Shafayat-Alam/Flapping-Foil-Propulsors-Control/subsea_mission_assurance/docs/00_Model_Report.md

# Model Report — Soft Propulsors UUV
_Generated 2026-09-03._

## Element counts

- stakeholders: 3
- expectations: 3
- moes: 1
- mops: 3
- requirements: 28
- components: 17
- interfaces: 13
- activities: 38

## V&V resourcing policy

- **Software:** Unlimited. Any form acceptable — manual or automated (host-side, sim, on-target).
- **Hardware:** Constrained to basic shop tools plus some university-lab equipment. Each hardware activity's required instrument MUST be confirmed available before it is baselined; if unavailable, substitute a documented low-cost method or mark the activity BLOCKED.
- **Confirmed tools:** digital calipers, digital scale (g), hanging/spring scale (force), tape measure / ruler, digital multimeter, food coloring / dye, thermometer / IR temp gun, overhead phone camera + mount, waterproof AprilTags + stands, stopwatch / phone timer, known calibration weights
- **Unavailable tools:** bench DC power supply, oscilloscope, clamp/inline current meter, syringe + tubing (vacuum), desiccant / humidity card

## Consistency check

**0 error(s), 0 warning(s)**

## Generated views

- `01_Stakeholder_Expectations.md`
- `02_MOE_MOP.md`
- `03_System_Requirements.md`
- `04_Architecture.md`
- `05_OPM_OPL.md`
- `06_Verification_Procedures.md`
- `07_ConOps.md`
- `08_Software_Safety.md`
- `09_Risk_Register.md`
- `10_Interface_Requirements.md`
- `11_Interface_Design.md`
- `12_ICD.md`
- `13_Integration_Plan.md`
- `14_DSM.md`
- `15_Commissioning.md`
- `16_Test_Strategy.md`
- `17_V_Model.md`
- `Commissioning_Checklist.csv`
- `DSM.csv`
- `ICD.csv`
- `INDEX.md`
- `Integration_Plan.csv`
- `Interface_Requirements.csv`
- `Interfaces.csv`
- `Requirements_Traceability_Matrix.csv`
- `Risk_Register.csv`
- `Scenario_Traceability_Matrix.csv`
- `Software_Hazard_Matrix.csv`
- `V_Model_Diagram.svg`
- `Verification_Matrix.csv`
