Shafayat-Alam/Flapping-Foil-Propulsors-Control/for_drive/MANIFEST.md

# Files staged for the external drive

This folder mirrors the destination structure on `/mnt/usb/Fin_Dynmaics/`.
At the end of the full walkthrough, copy each file below to the listed
destination (drive is currently not writable from this session — see chat).

| Local staged file | Destination on drive | Status |
|---|---|---|
| `for_drive/Fin_Dynmaics/phase1_targets.png` | `/mnt/usb/Fin_Dynmaics/phase1_targets.png` | ✅ copied |
