Shafayat-Alam/Flapping-Foil-Propulsors-Control/subsea_mission_assurance/docs/01_Stakeholder_Expectations.md

# Stakeholder Expectations
_Generated 2026-09-03 from model/. Do not edit._

### STK-PI — Principal investigator / student researcher
- **STK-EXP-01** (draft): Demonstrate autonomous homing to an AprilTag using soft flapping propulsion.

### STK-LAB — Lab / facility owner
- **STK-EXP-03** (draft): Cause no water damage to the facility; remain watertight and recoverable.

### STK-SAF — Safety observer
- **STK-EXP-02** (draft): Operate without shock, thermal, or entanglement hazard to people.
