Shafayat-Alam/Flapping-Foil-Propulsors-Control/for_drive/3D_parametric_amp-ratio_freq-ratio_phase-shift/amplitude_ratio_fx_fy.png

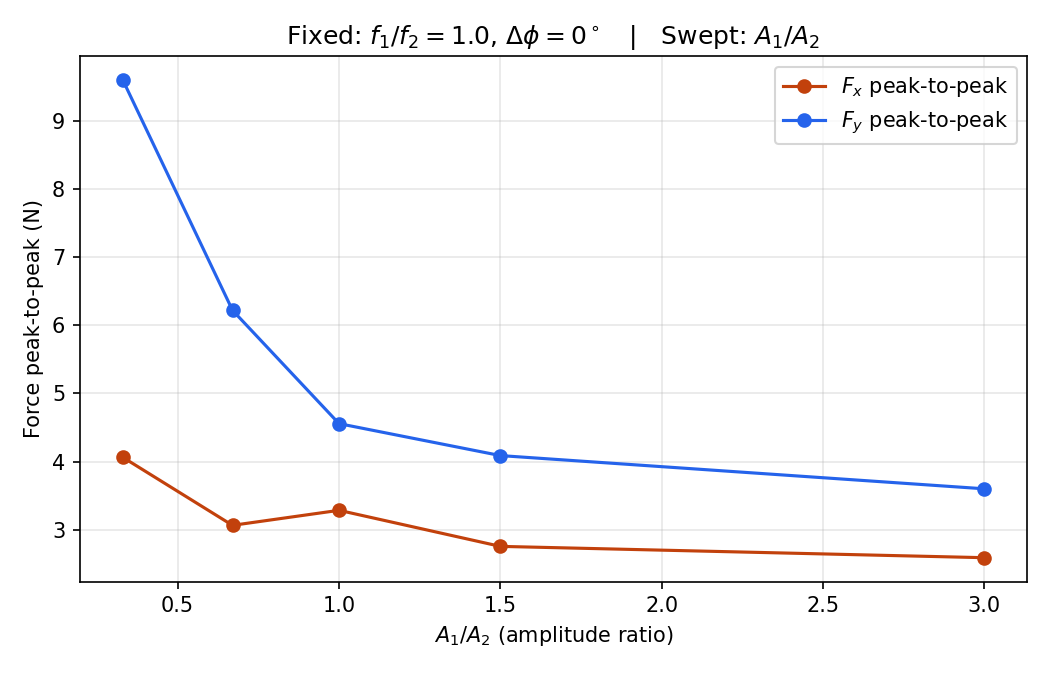
for_drive/3D_parametric_amp-ratio_freq-ratio_phase-shift/amplitude_ratio_fx_fy.png
