Shafayat-Alam/Flapping-Foil-Propulsors-Control/for_drive/3D_parametric_amp-ratio_freq-ratio_phase-shift/claim_7_peak_count_coupling.png

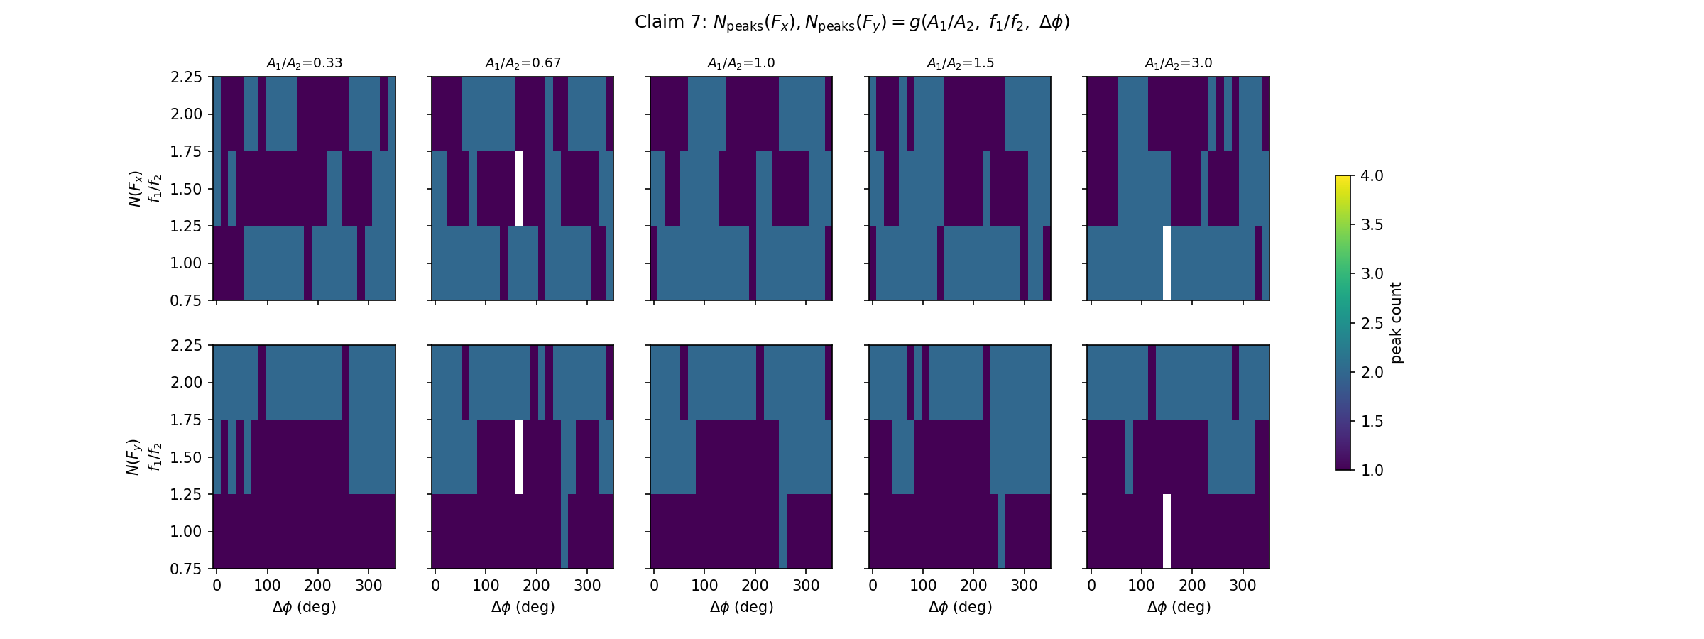
for_drive/3D_parametric_amp-ratio_freq-ratio_phase-shift/claim_7_peak_count_coupling.png
