Shafayat-Alam/Flapping-Foil-Propulsors-Control/for_drive/3D_parametric_amp-ratio_freq-ratio_phase-shift/claims_1_2_amplitude_ratio.png

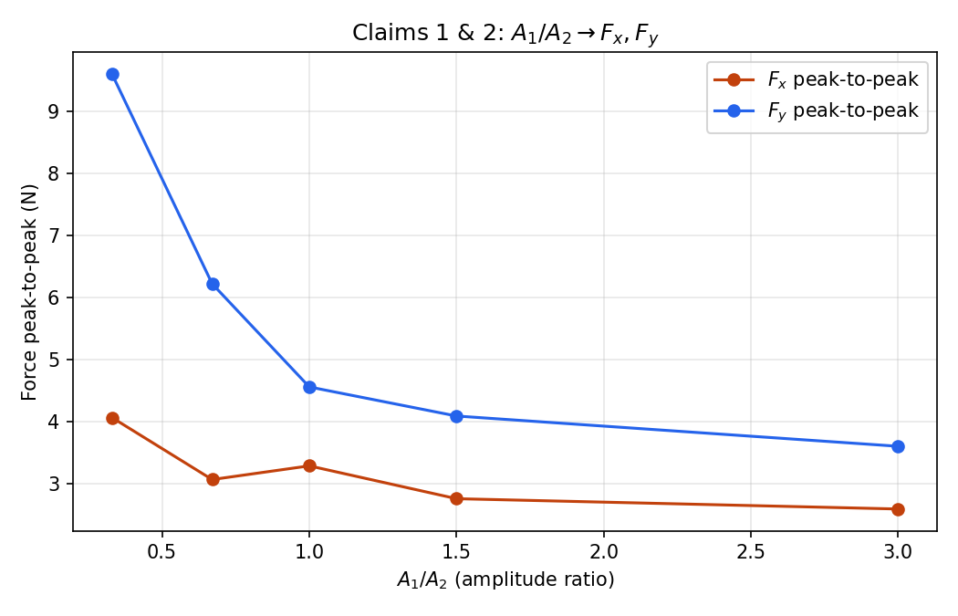
for_drive/3D_parametric_amp-ratio_freq-ratio_phase-shift/claims_1_2_amplitude_ratio.png
