Shafayat-Alam/Flapping-Foil-Propulsors-Control/for_drive/3D_parametric_amp-ratio_freq-ratio_phase-shift/claims_3_4_frequency_ratio.png

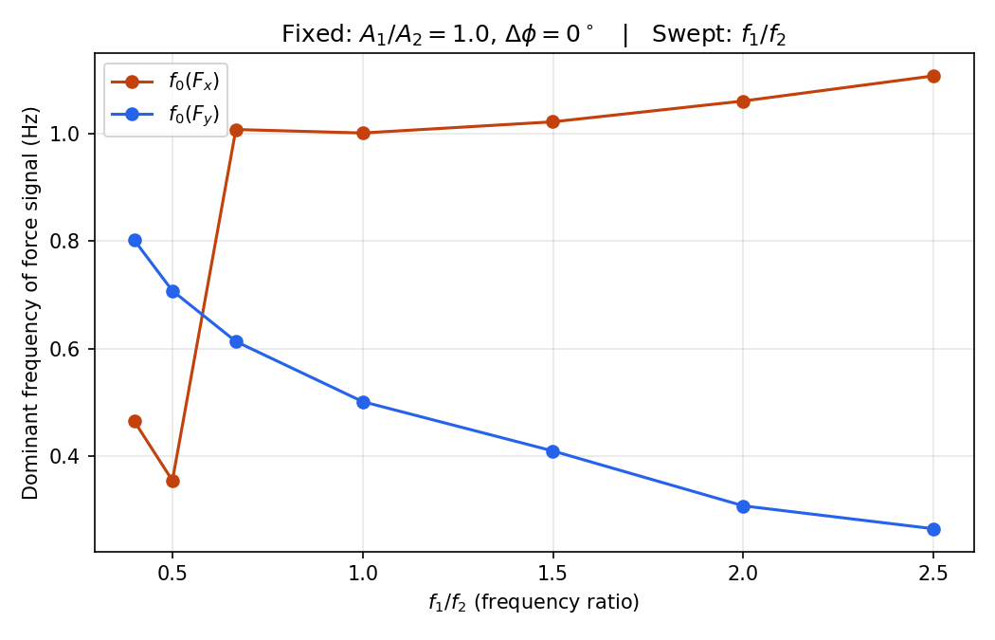
for_drive/3D_parametric_amp-ratio_freq-ratio_phase-shift/claims_3_4_frequency_ratio.png
