Shafayat-Alam/Flapping-Foil-Propulsors-Control/for_drive/3D_parametric_amp-ratio_freq-ratio_phase-shift/claims_5_6_phase_skew.png

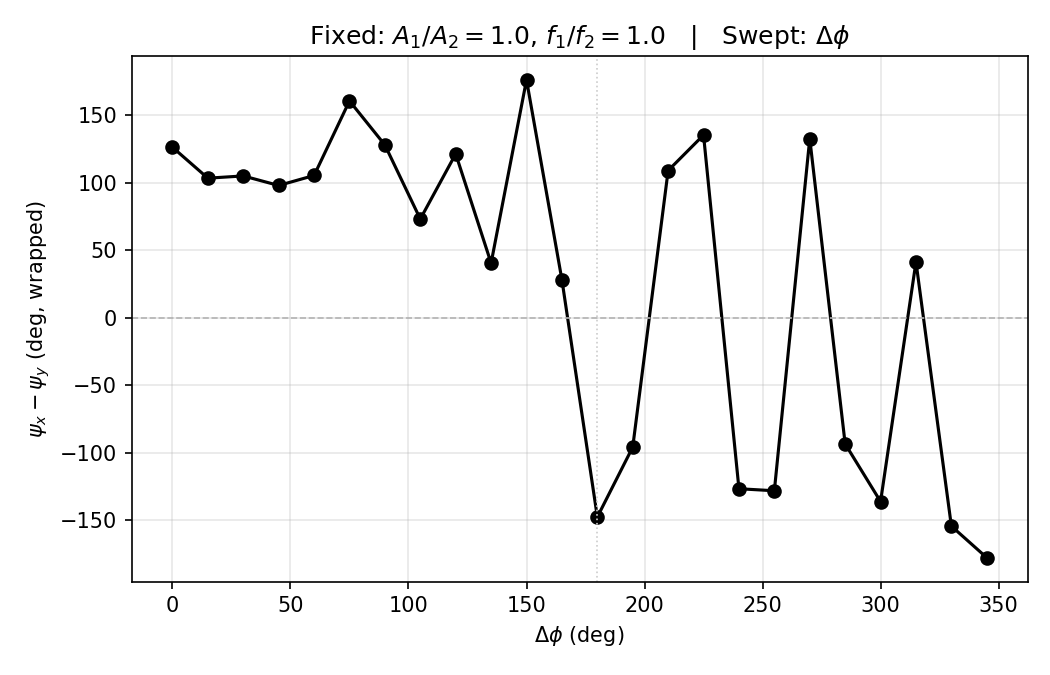
for_drive/3D_parametric_amp-ratio_freq-ratio_phase-shift/claims_5_6_phase_skew.png
