Shafayat-Alam/Flapping-Foil-Propulsors-Control/for_drive/3D_parametric_amp-ratio_freq-ratio_phase-shift/fz_p2p_coupling.png

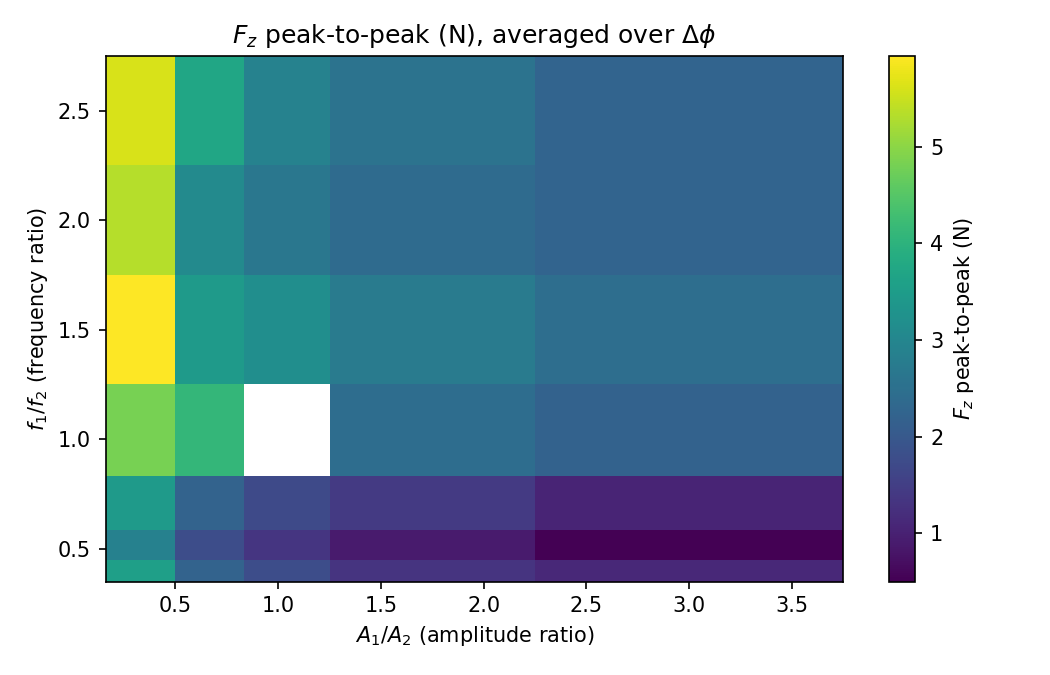
for_drive/3D_parametric_amp-ratio_freq-ratio_phase-shift/fz_p2p_coupling.png
