Shafayat-Alam/Flapping-Foil-Propulsors-Control/for_drive/3D_parametric_k_freq-ratio_phase-shift/k_sweep_force_snapshot.png

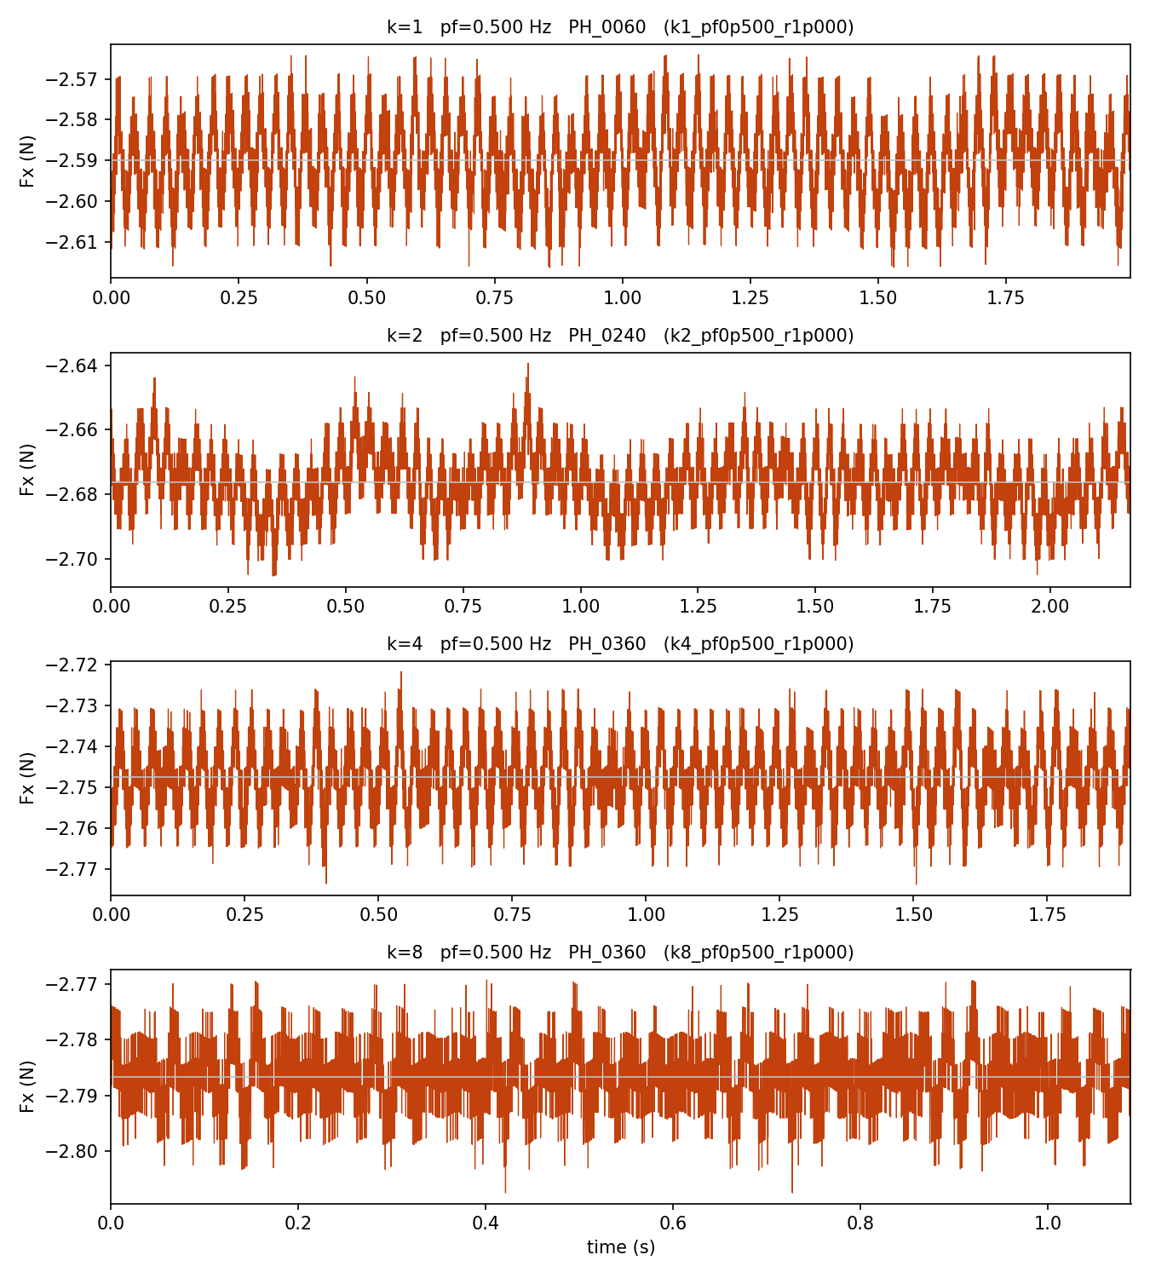
for_drive/3D_parametric_k_freq-ratio_phase-shift/k_sweep_force_snapshot.png
