Shafayat-Alam/Flapping-Foil-Propulsors-Control/for_drive/Fin_Dynmaics/phase1_targets.png

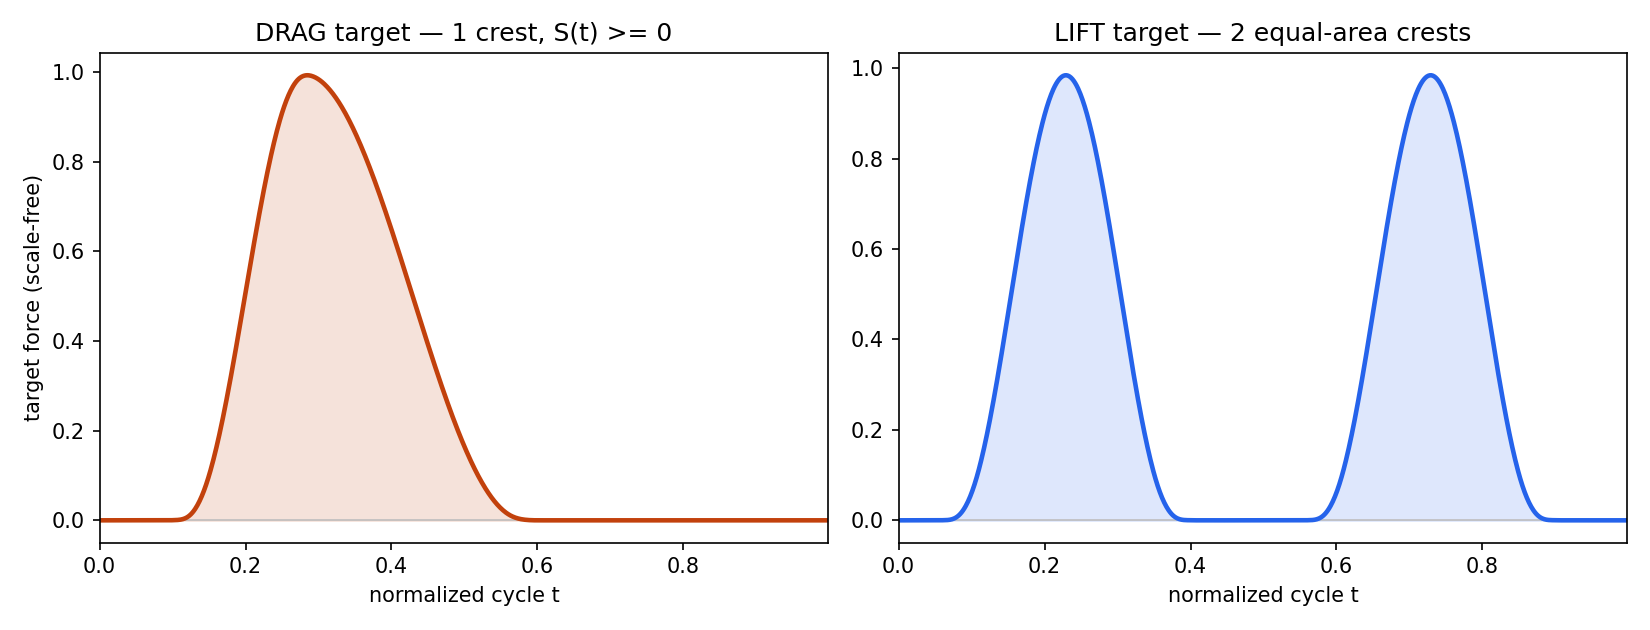
for_drive/Fin_Dynmaics/phase1_targets.png
