Shafayat-Alam/Flapping-Foil-Propulsors-Control/for_drive/profile_definition/bspline_drag.png

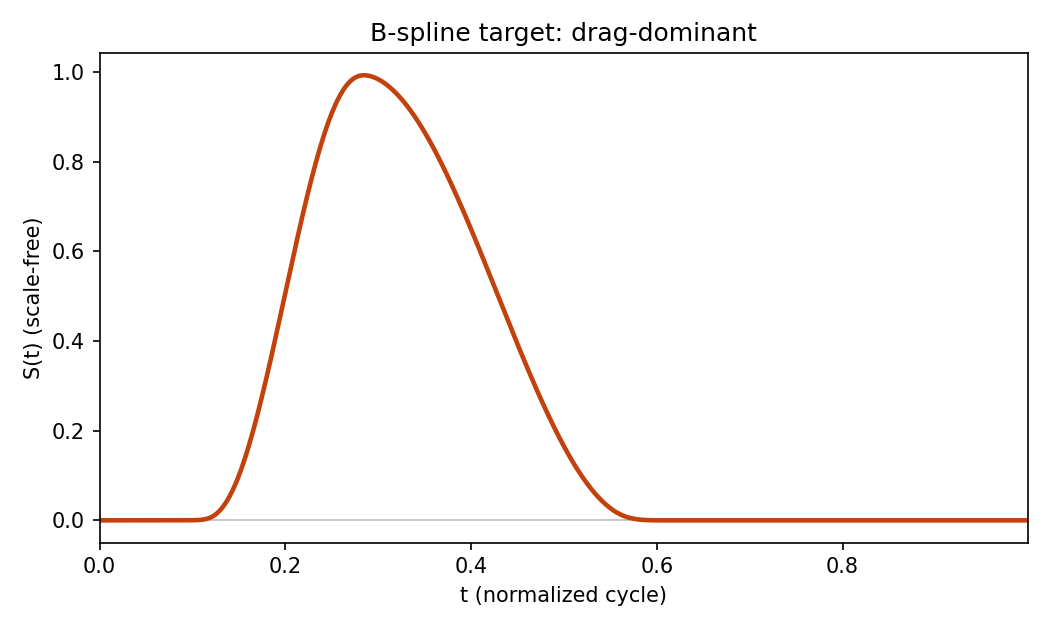
for_drive/profile_definition/bspline_drag.png
