Shafayat-Alam/Flapping-Foil-Propulsors-Control/for_drive/profile_definition/bspline_lift.png

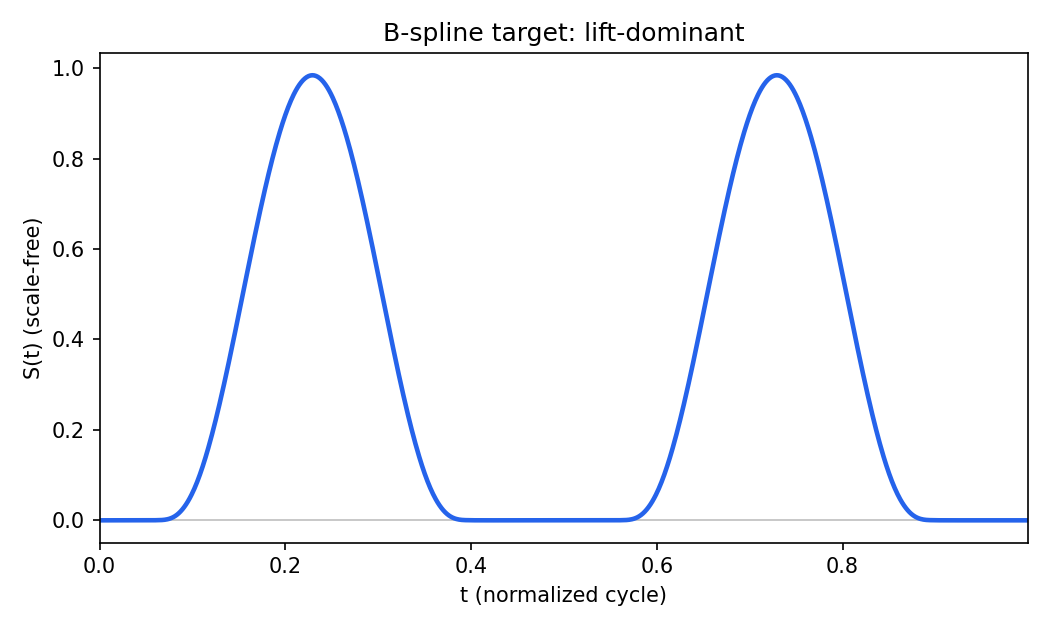
for_drive/profile_definition/bspline_lift.png
