Shafayat-Alam/Flapping-Foil-Propulsors-Control/for_drive/recent_generated_plots/CONTROL_RESPONSE_ERROR.png

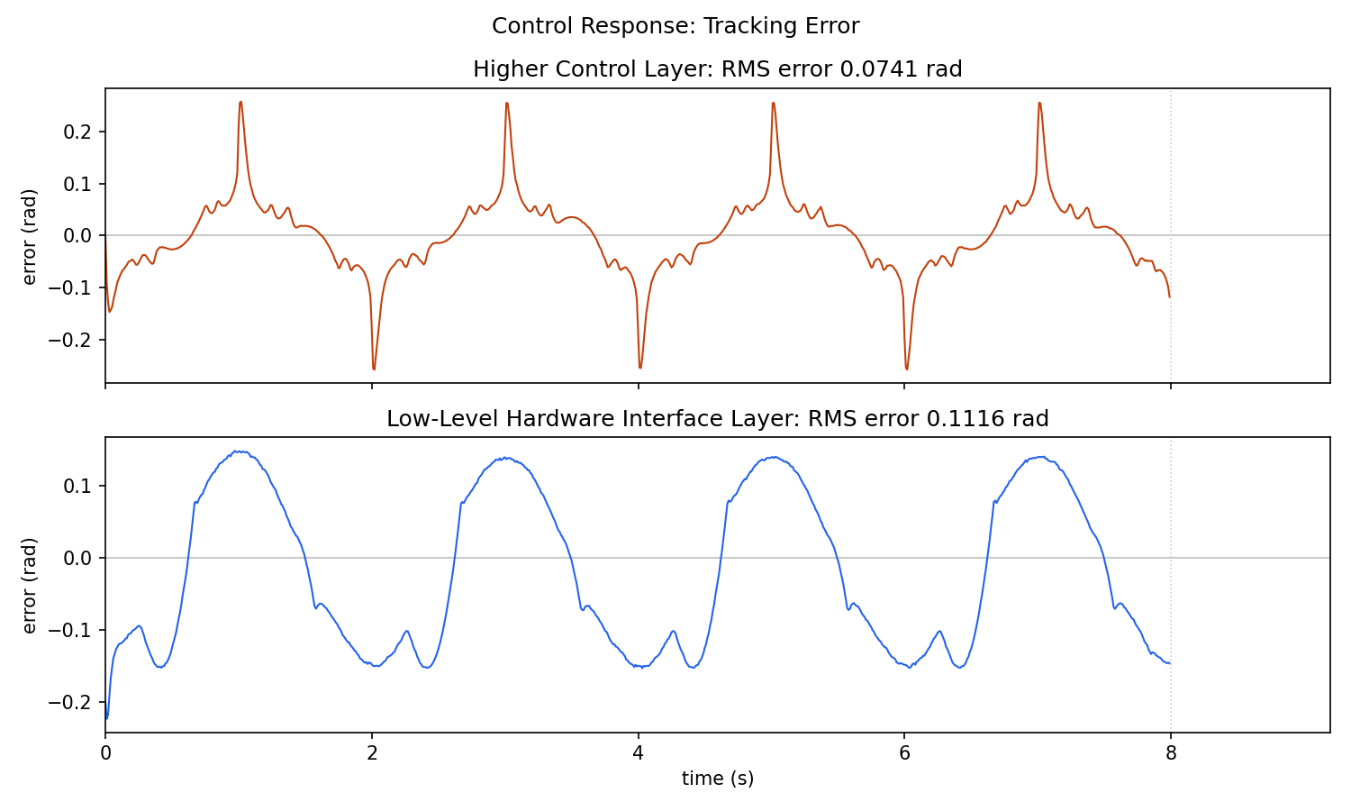
for_drive/recent_generated_plots/CONTROL_RESPONSE_ERROR.png
