Shafayat-Alam/Flapping-Foil-Propulsors-Control/for_drive/recent_generated_plots/CONTROL_RESPONSE_LOOPS.png

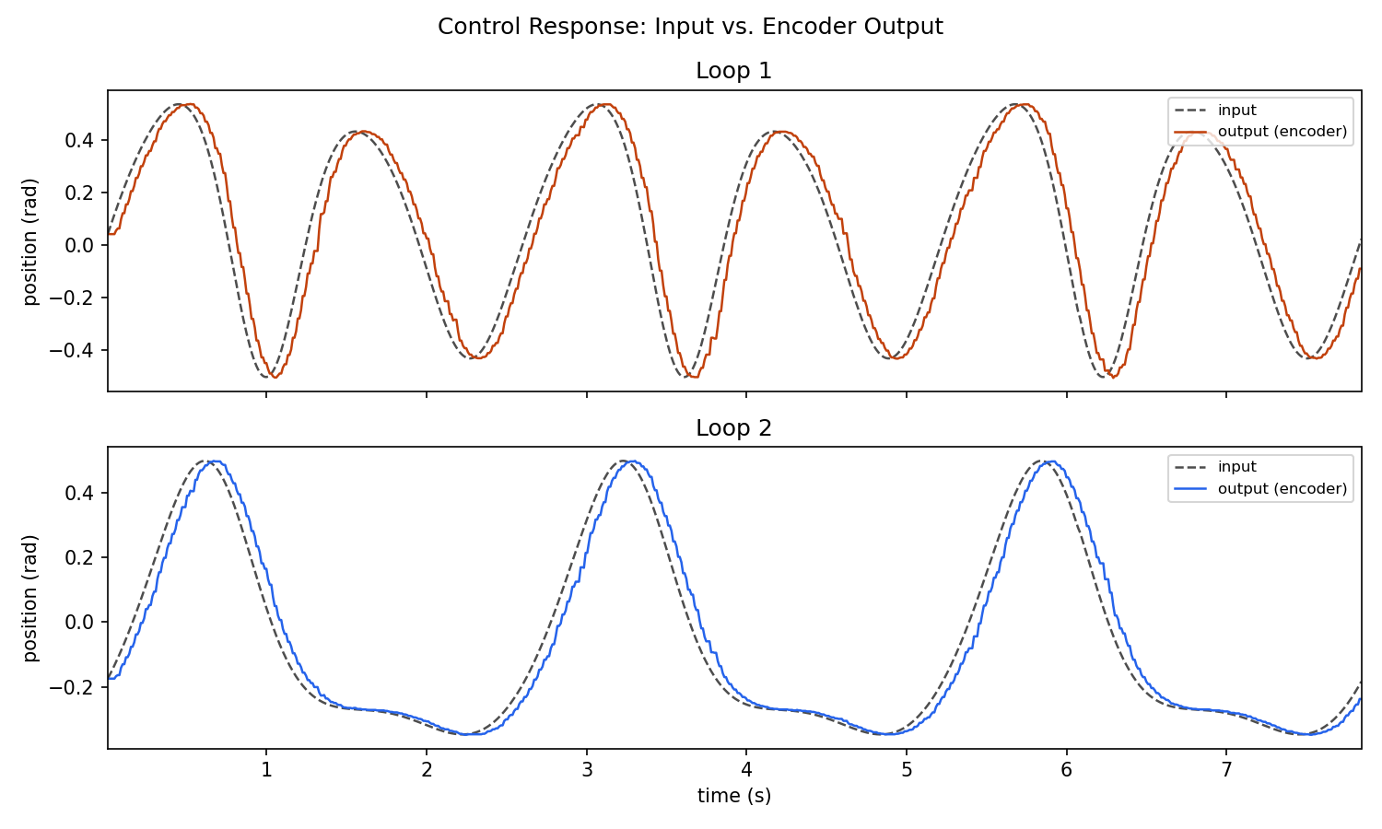
for_drive/recent_generated_plots/CONTROL_RESPONSE_LOOPS.png
