Shafayat-Alam/Flapping-Foil-Propulsors-Control/for_drive/recent_generated_plots/CRAB_FREQ_COMPARISON.png

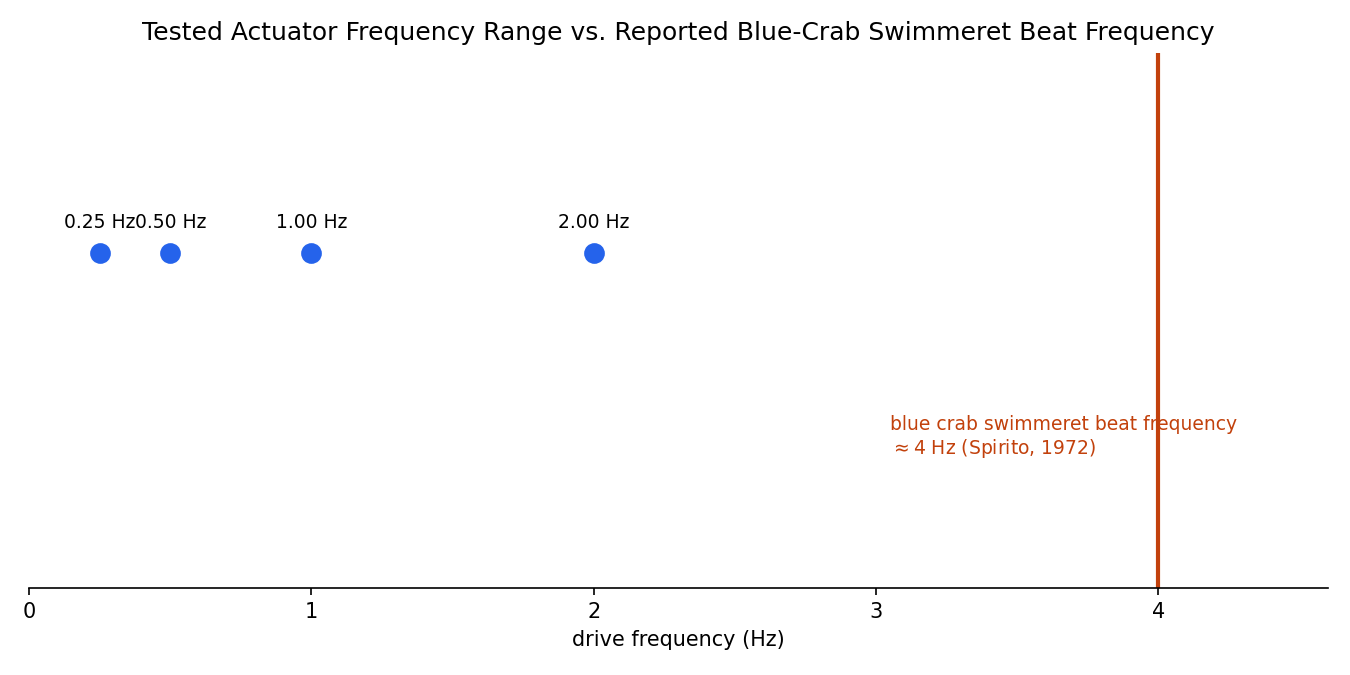
for_drive/recent_generated_plots/CRAB_FREQ_COMPARISON.png
