Shafayat-Alam/Flapping-Foil-Propulsors-Control/for_drive/recent_generated_plots/DRAG_OVERLAY.png

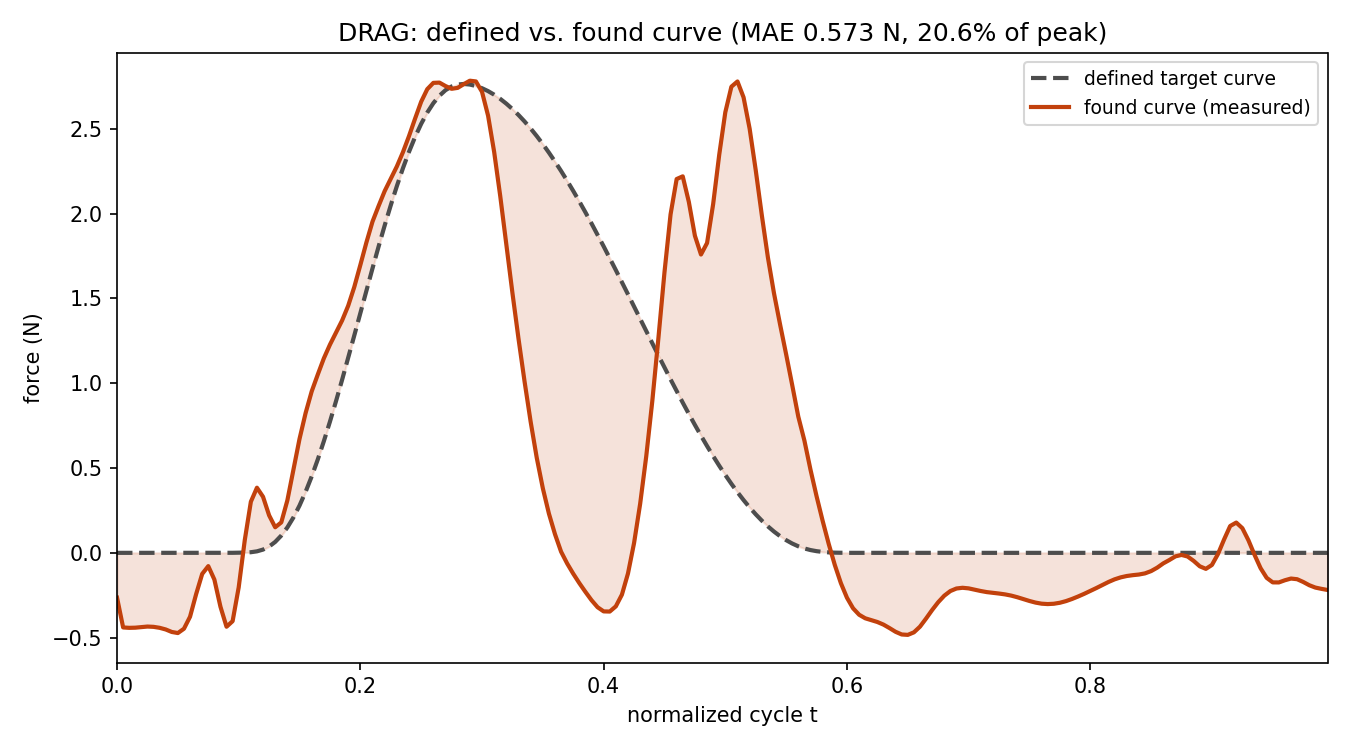
for_drive/recent_generated_plots/DRAG_OVERLAY.png
