Shafayat-Alam/Flapping-Foil-Propulsors-Control/for_drive/recent_generated_plots/FORCE_TARGET_CURVES_simplified.png

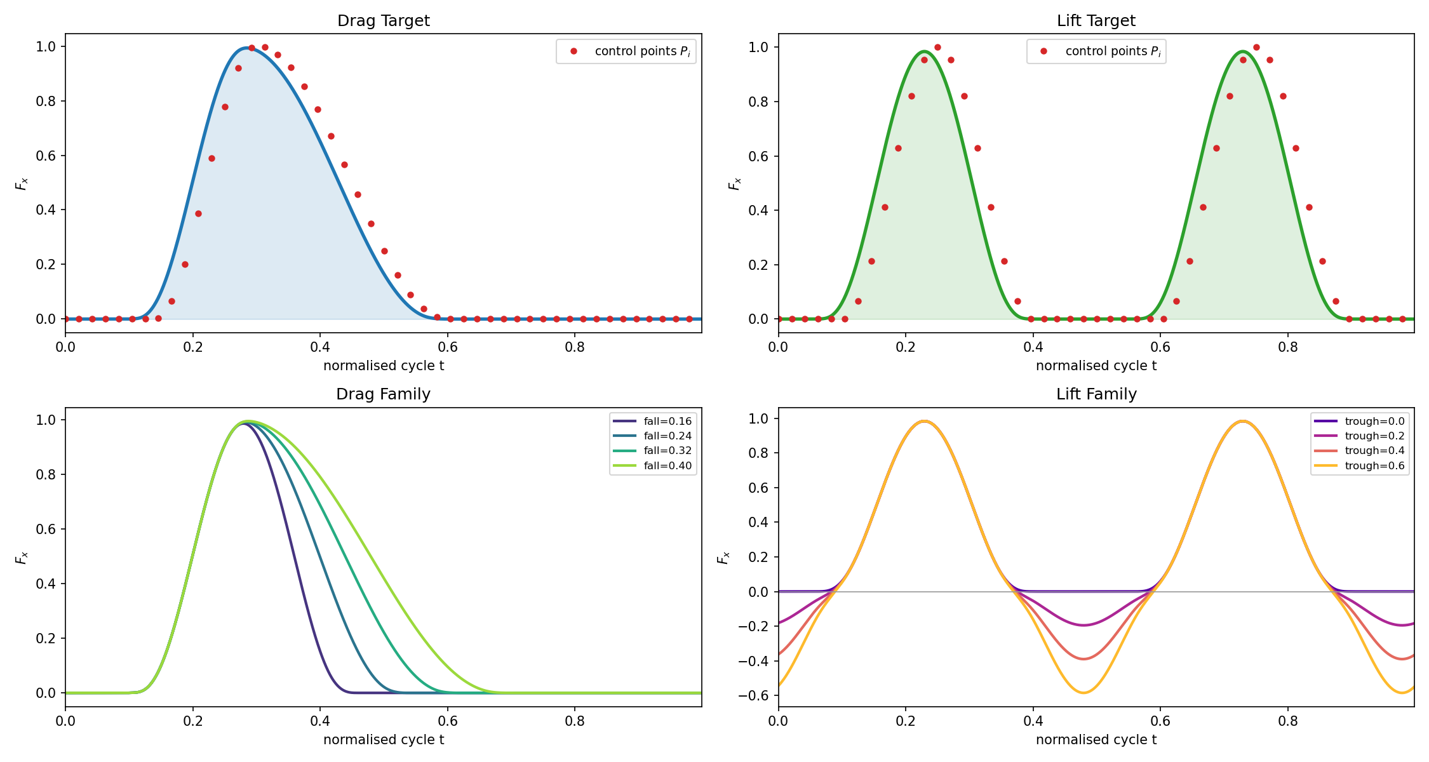
for_drive/recent_generated_plots/FORCE_TARGET_CURVES_simplified.png
