Shafayat-Alam/Flapping-Foil-Propulsors-Control/for_drive/recent_generated_plots/LIFT_OVERLAY.png

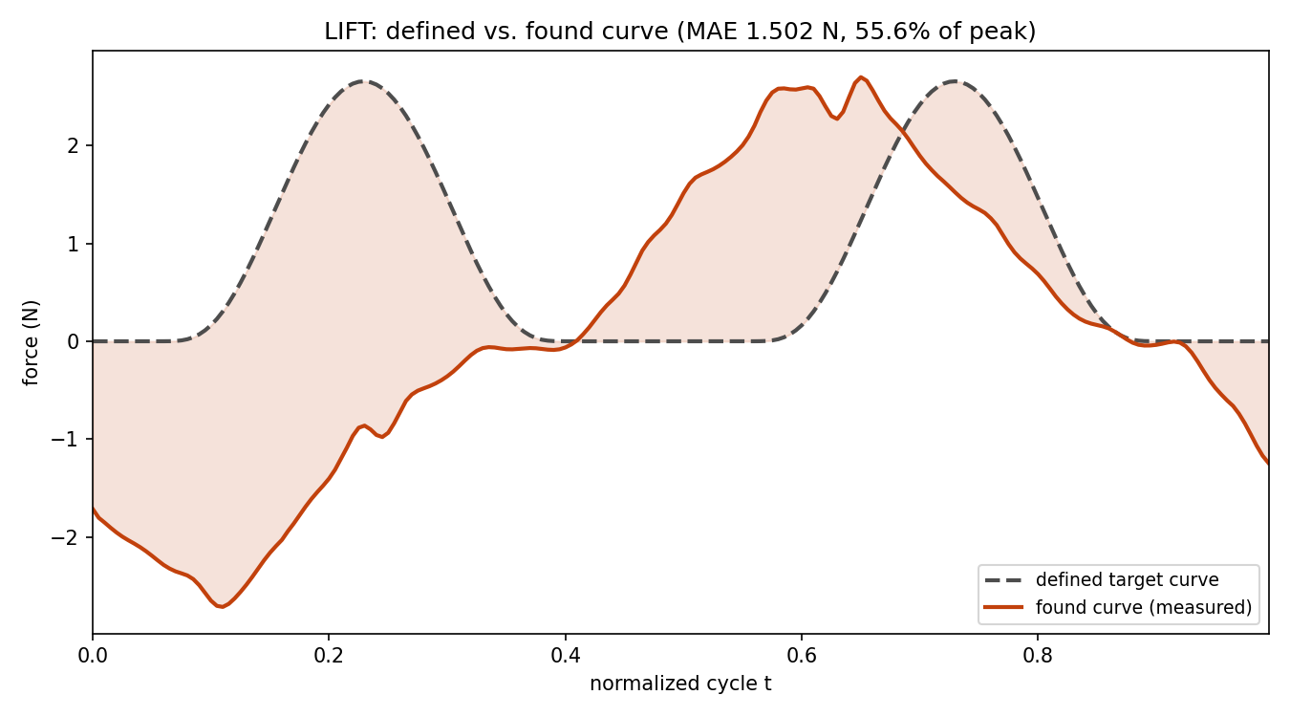
for_drive/recent_generated_plots/LIFT_OVERLAY.png
