Shafayat-Alam/Flapping-Foil-Propulsors-Control/for_drive/recent_generated_plots/LIFT_WORST_OVERLAY.png

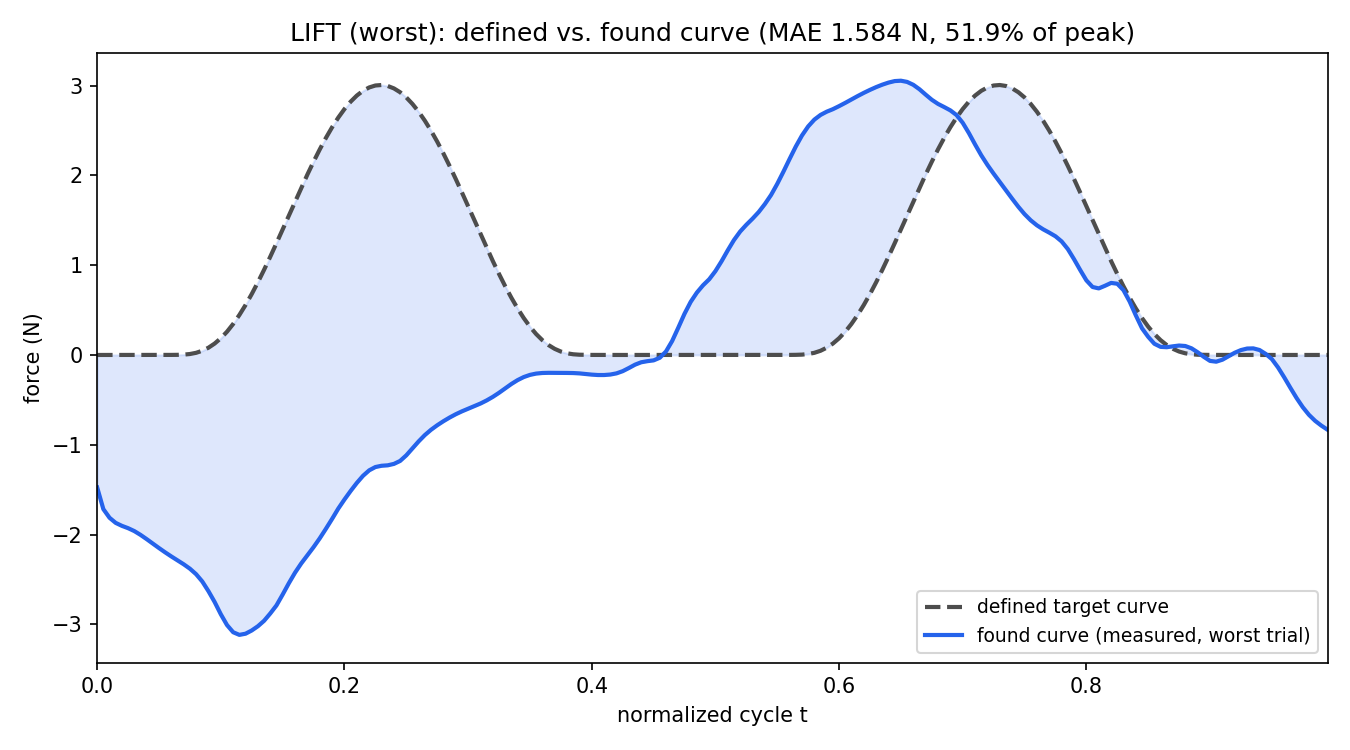
for_drive/recent_generated_plots/LIFT_WORST_OVERLAY.png
