Shafayat-Alam/Flapping-Foil-Propulsors-Control/for_drive/recent_generated_plots/pchip_drag_official.png

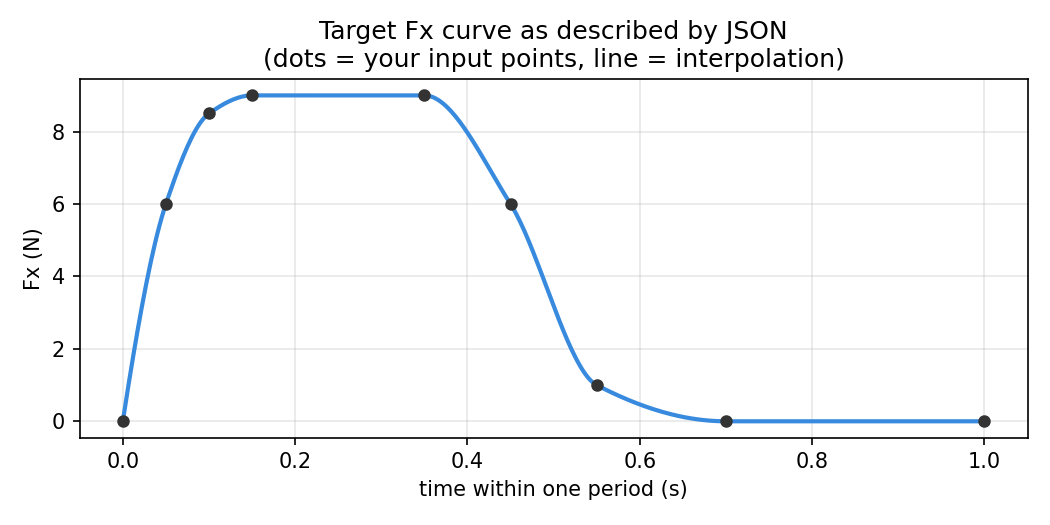
for_drive/recent_generated_plots/pchip_drag_official.png
