Shafayat-Alam/Flapping-Foil-Propulsors-Control/for_drive/recent_generated_plots/pchip_lift_official.png

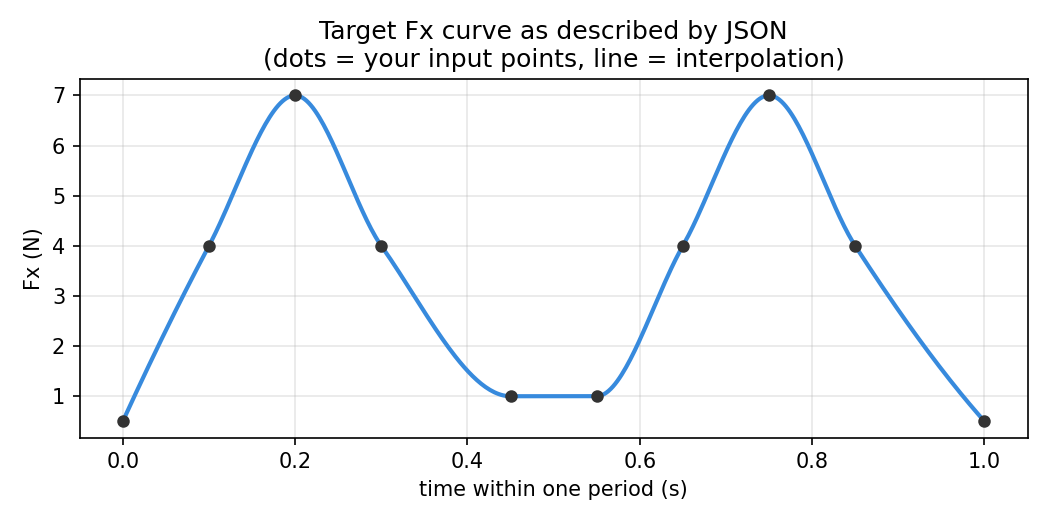
for_drive/recent_generated_plots/pchip_lift_official.png
