Shafayat-Alam/Flapping-Foil-Propulsors-Control/for_drive/recent_generated_plots/PCHIP_TARGET_CURVES.png

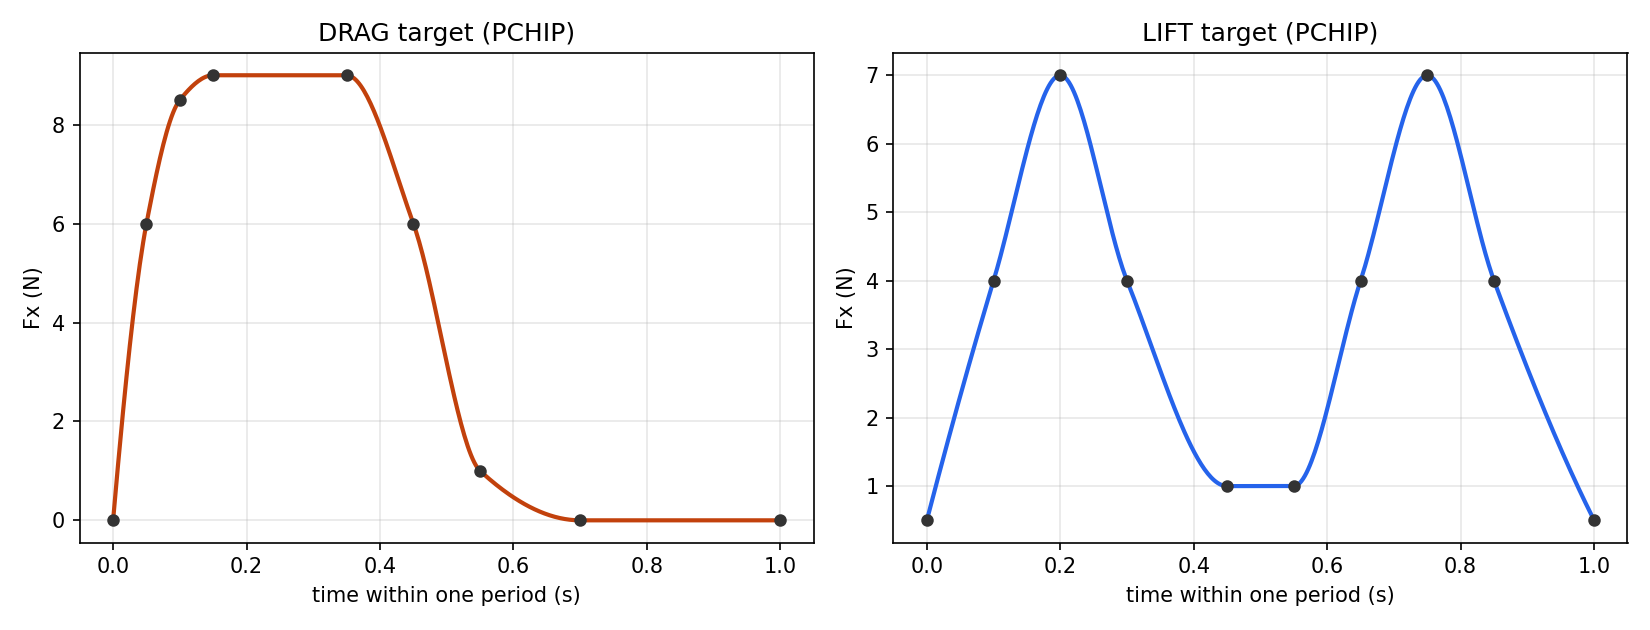
for_drive/recent_generated_plots/PCHIP_TARGET_CURVES.png
