Shafayat-Alam/Flapping-Foil-Propulsors-Control/for_drive/recent_generated_plots/RESPONSE_RATE_BOTH_LAYERS.png

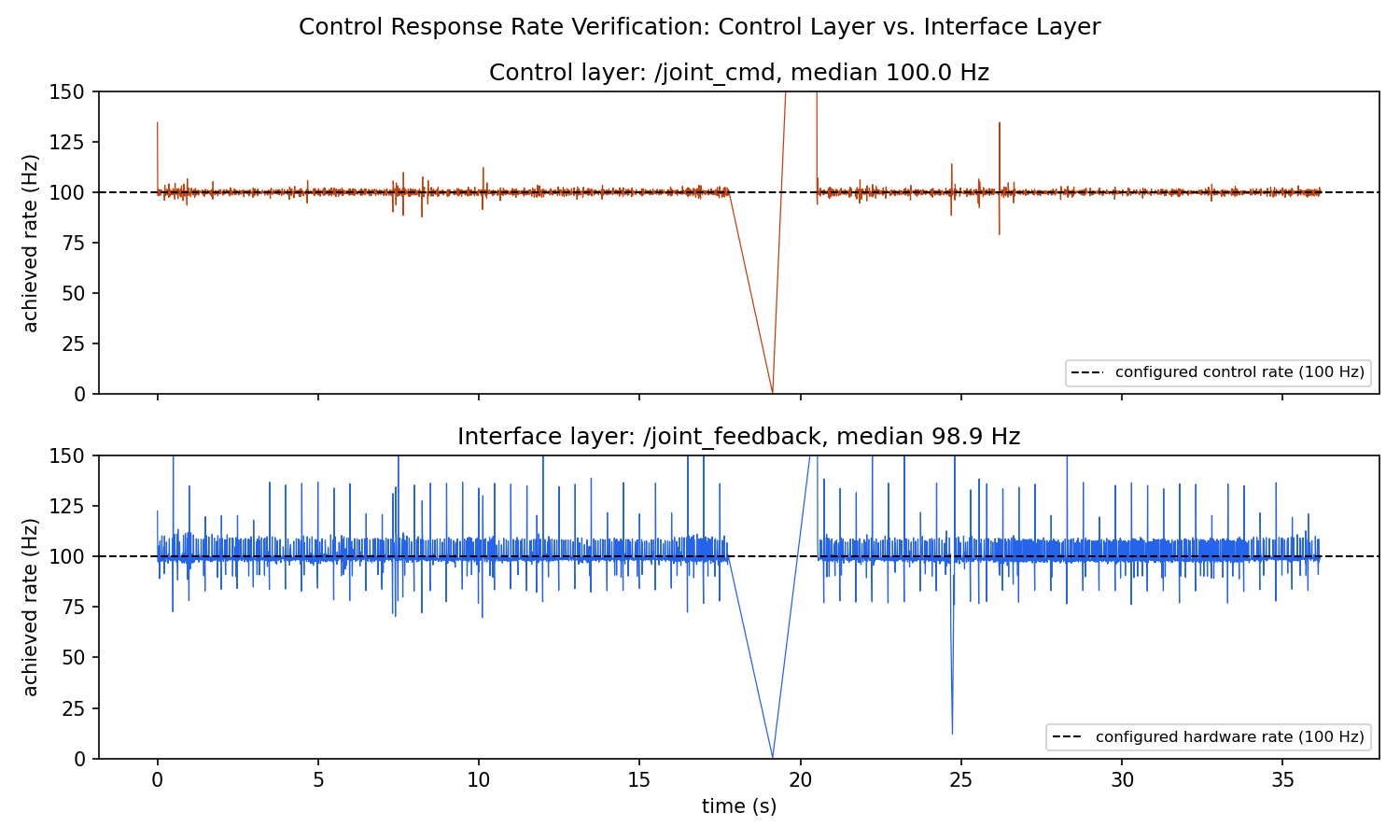
for_drive/recent_generated_plots/RESPONSE_RATE_BOTH_LAYERS.png
