Shafayat-Alam/Flapping-Foil-Propulsors-Control/for_drive/recent_generated_plots/RESPONSE_RATE_TRACKING.png

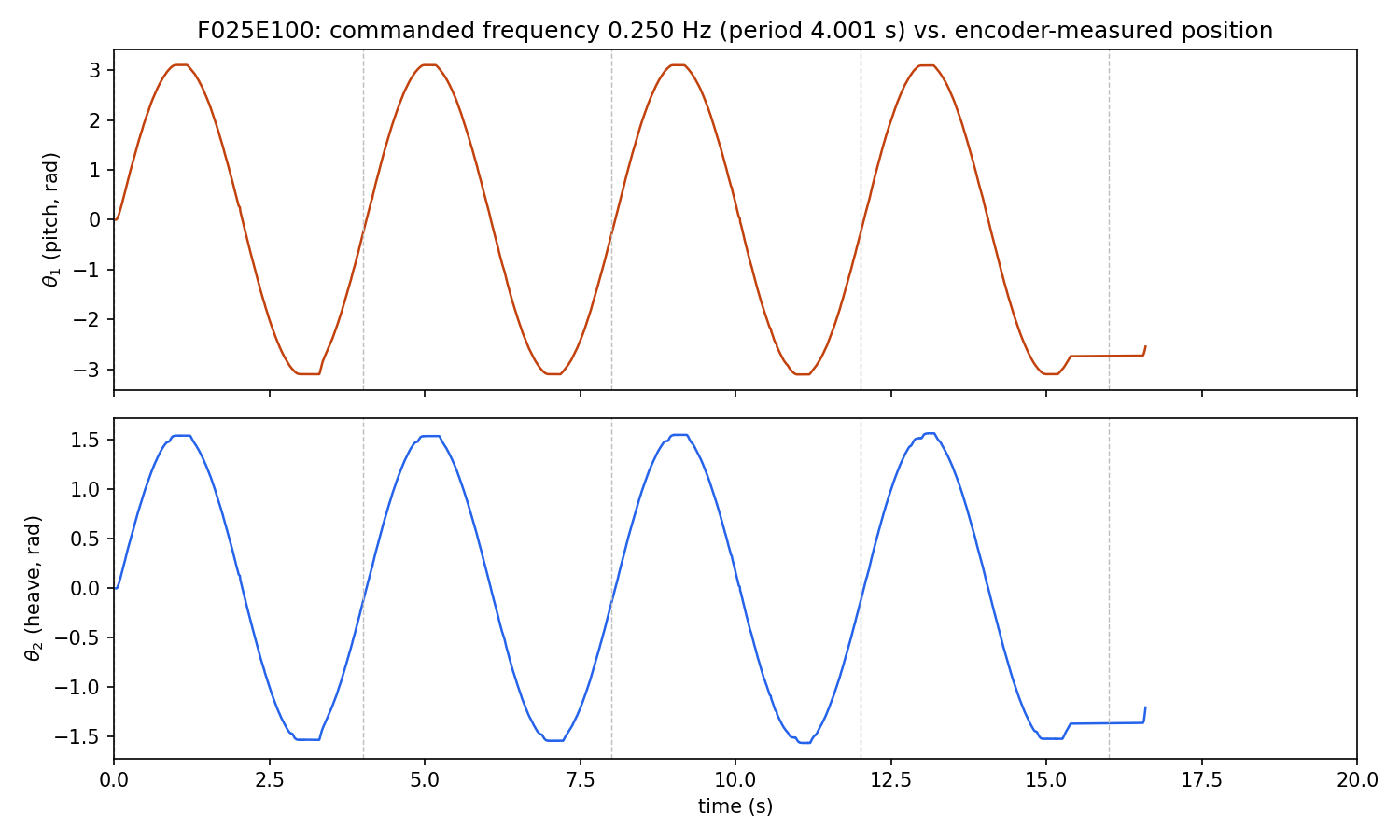
for_drive/recent_generated_plots/RESPONSE_RATE_TRACKING.png
