Shafayat-Alam/Flapping-Foil-Propulsors-Control/for_drive/recent_generated_plots/ROSGRAPH_LIVE.png

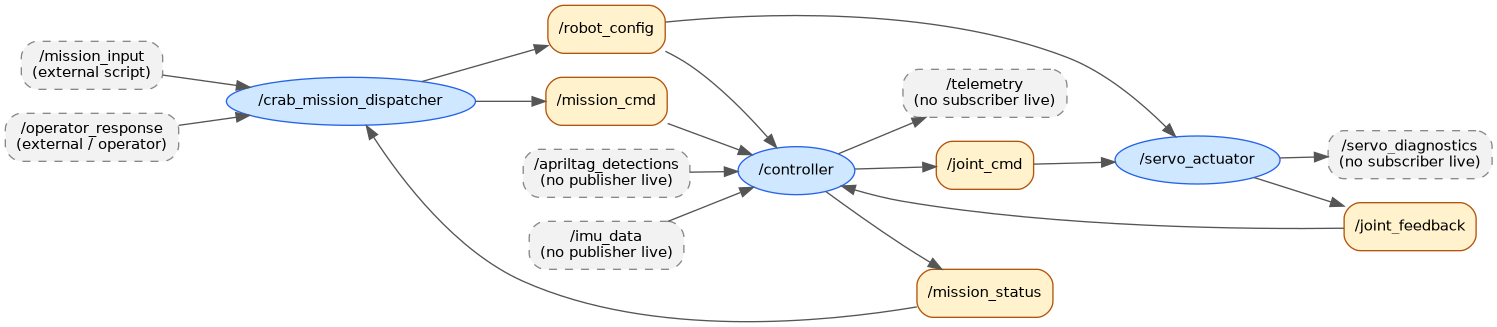
for_drive/recent_generated_plots/ROSGRAPH_LIVE.png
