Shafayat-Alam/Flapping-Foil-Propulsors-Control/for_drive/recent_generated_plots/SLEW_RATE_CHECK.png

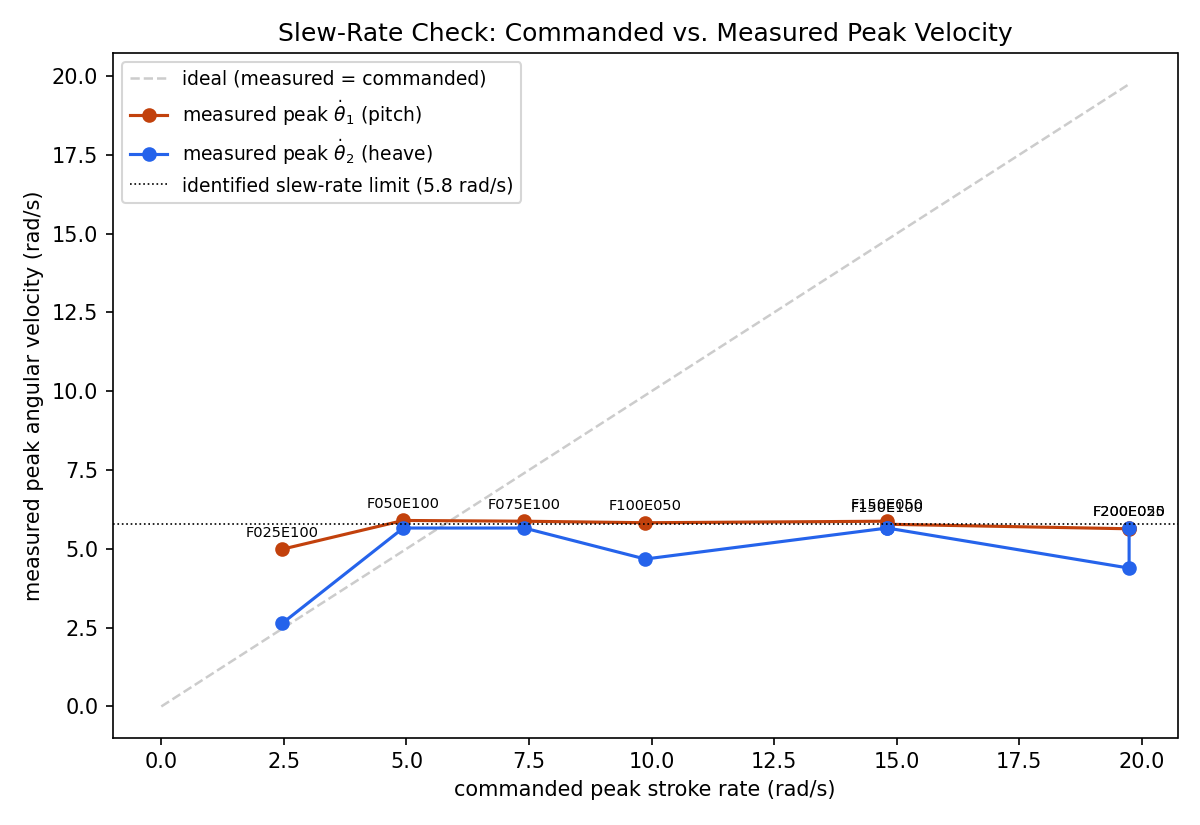
for_drive/recent_generated_plots/SLEW_RATE_CHECK.png
