Shafayat-Alam/Flapping-Foil-Propulsors-Control/for_drive/recent_generated_plots/SLEW_RATE_HEAVE.png

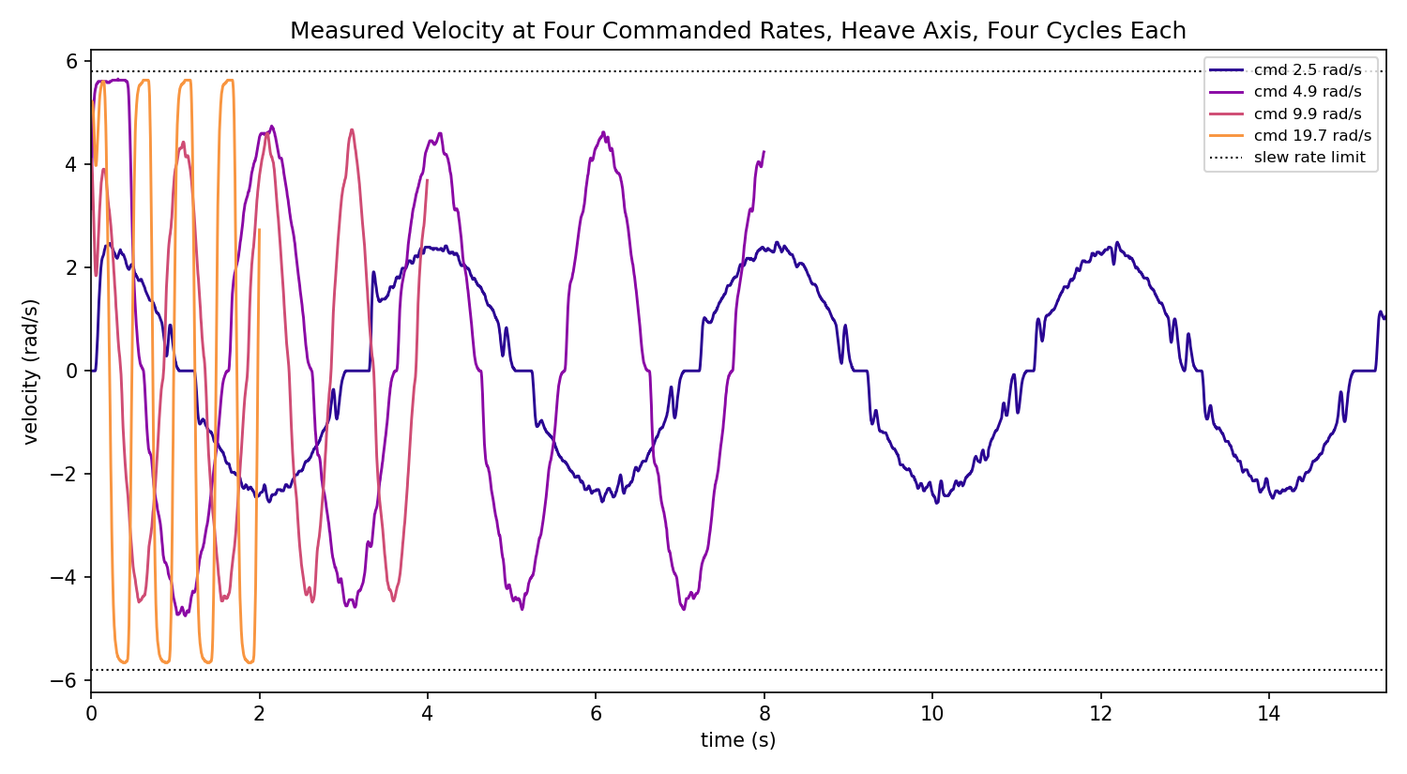
for_drive/recent_generated_plots/SLEW_RATE_HEAVE.png
