Shafayat-Alam/Flapping-Foil-Propulsors-Control/src/prototype_description/meshes/stellarhd-wetlink.stl

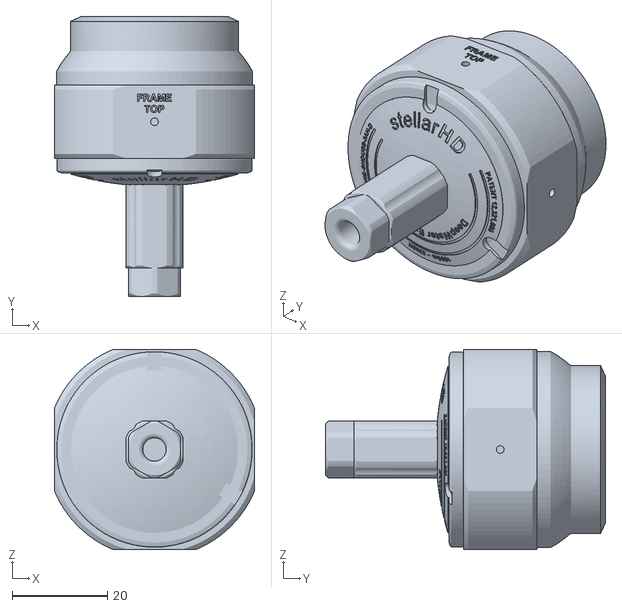
[picture p34: CAD file, 2026-06-30]
src/prototype_description/meshes/stellarhd-wetlink.stl
42.0 x 58.8 x 42.0
