Shafayat-Alam/Flapping-Foil-Propulsors-Control/src/prototype_description/meshes/left_FRX430-S105K.stl

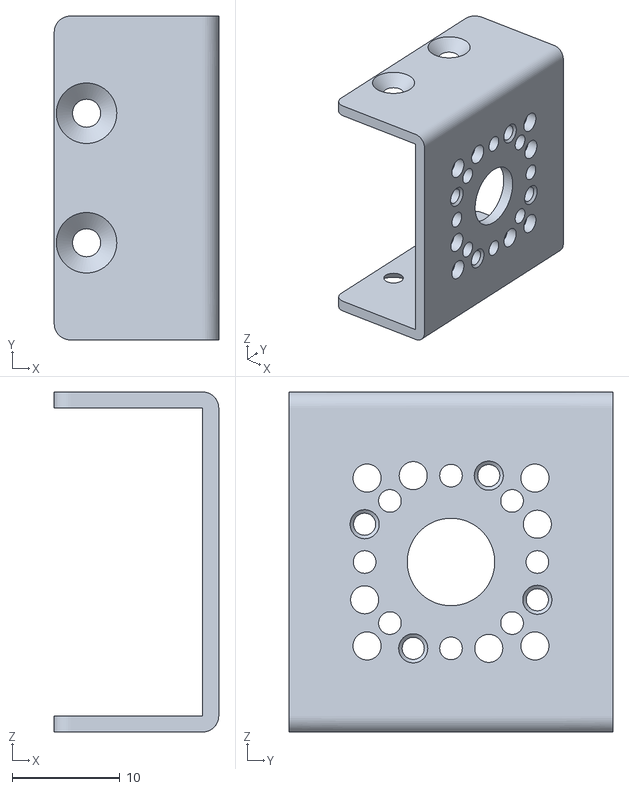
[picture p35: CAD file, 2026-06-30]
src/prototype_description/meshes/left_FRX430-S105K.stl
15.2 x 30.0 x 31.5
