Shafayat-Alam/Flapping-Foil-Propulsors-Control/src/prototype_description/meshes/electronics_box.stl

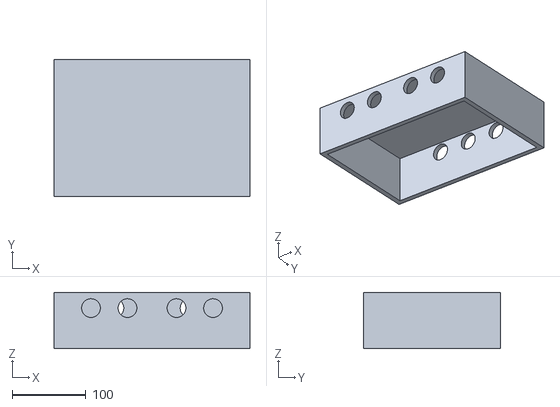
[picture p36: CAD file, 2026-06-30]
src/prototype_description/meshes/electronics_box.stl
265.0 x 185.0 x 76.0
