Shafayat-Alam/Flapping-Foil-Propulsors-Control/src/prototype_description/meshes/left_pitch_servo.stl

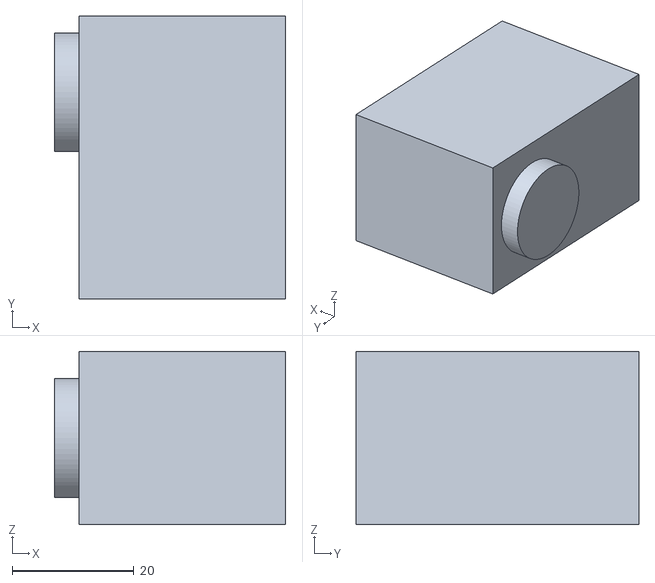
[picture p37: CAD file, 2026-06-30]
src/prototype_description/meshes/left_pitch_servo.stl
38.0 x 46.5 x 28.5
