Shafayat-Alam/Flapping-Foil-Propulsors-Control/src/prototype_description/meshes/left_Aerial_Truss_Structure3.stl

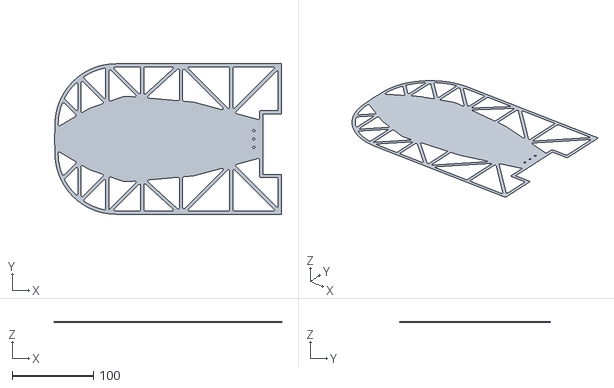
[picture p38: CAD file, 2026-06-30]
src/prototype_description/meshes/left_Aerial_Truss_Structure3.stl
279.0 x 185.0 x 0.4
