Shafayat-Alam/Flapping-Foil-Propulsors-Control/src/prototype_description/meshes/stellarhd-bracket.stl

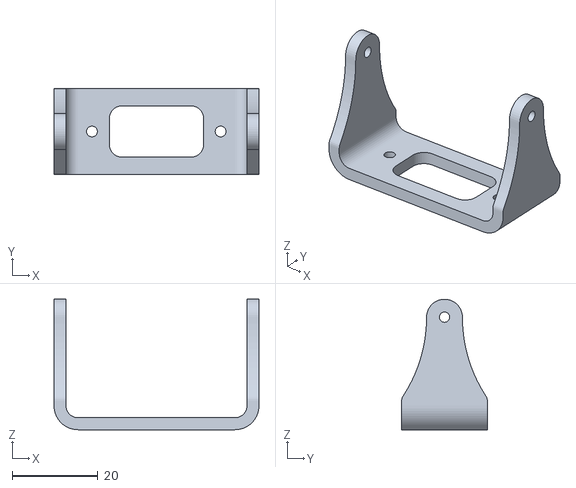
[picture p39: CAD file, 2026-06-30]
src/prototype_description/meshes/stellarhd-bracket.stl
47.8 x 20.0 x 30.4
