Shafayat-Alam/Flapping-Foil-Propulsors-Control/src/prototype_description/meshes/base_link.stl

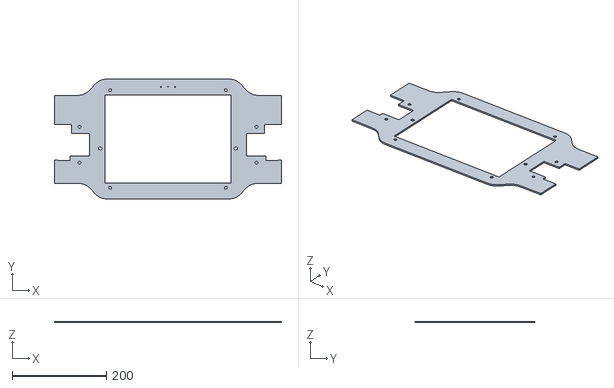
[picture p40: CAD file, 2026-06-30]
src/prototype_description/meshes/base_link.stl
481.0 x 254.0 x 3.15
