Shafayat-Alam/Flapping-Foil-Propulsors-Control/src/prototype_description/meshes/left_FRX430-H105K.stl

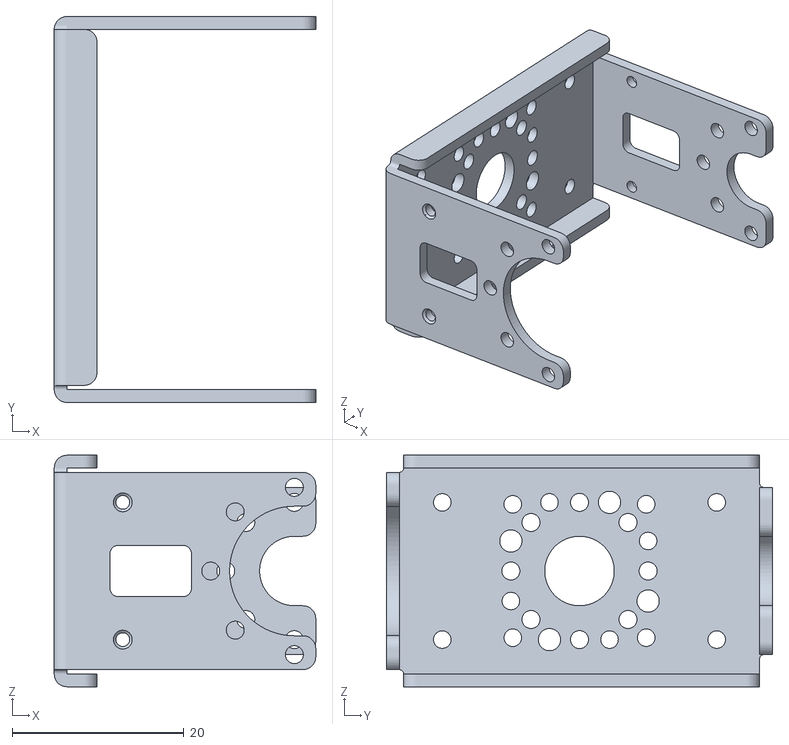
[picture p41: CAD file, 2026-06-30]
src/prototype_description/meshes/left_FRX430-H105K.stl
30.5 x 45.0 x 27.0
