Shafayat-Alam/Flapping-Foil-Propulsors-Control/src/prototype_description/meshes/Component87.stl

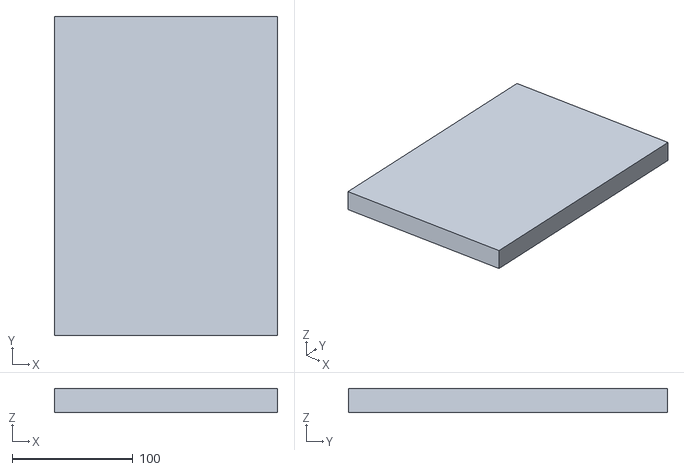
[picture p42: CAD file, 2026-05-20]
src/prototype_description/meshes/Component87.stl
185.0 x 265.0 x 20.0
