Shafayat-Alam/Flapping-Foil-Propulsors-Control/(list of files, cad)

Other CAD files:
src/prototype_description/meshes/right_Aerial_Truss_Structure3.stl
src/prototype_description/meshes/right_roll_servo.stl
src/prototype_description/meshes/right_pitch_servo.stl
src/prototype_description/meshes/left_roll_servo.stl
src/prototype_description/meshes/right_pitch_FRX430-H105K.stl
src/prototype_description/meshes/right_FRX430-S105K.stl
