Shafayat-Alam/Flapping-Foil-Propulsors-Control/test/session.csv

bag_time_s | bag_time_ns | mission_label | mission_state | mission_event | source | msg_type | data | data.0 | data.1 | data.10 | data.11 | data.2 | data.3 | data.4 | data.5 | data.6 | data.7 | data.8 | data.9 | file | function | layout.data_offset | level | line | msg | name | s1_cmd_mode | s1_cmd_value | s1_current_a | s1_hw_error | s1_mode | s1_moving | s1_moving_status | s1_position_rad | s1_position_traj_rad | s1_pwm | s1_temp_C | s1_velocity_rps | s1_velocity_traj_rps | s1_voltage_v | s2_cmd_mode | s2_cmd_value | s2_current_a | s2_hw_error | s2_mode | s2_moving | s2_moving_status | s2_position_rad | s2_position_traj_rad | s2_pwm | s2_temp_C | s2_velocity_rps | s2_velocity_traj_rps | s2_voltage_v | stamp.nanosec | stamp.sec
1783813322.1456945 | 1783813322145694460 | idle | UNKNOWN |  | /rosout | rcl_interfaces/msg/Log |  |  |  |  |  |  |  |  |  |  |  |  |  | ./src/rosbag2_transport/recorder.cpp | RecorderImpl |  | 20 | 190 | Press SPACE for pausing/resuming | rosbag2_recorder |  |  |  |  |  |  |  |  |  |  |  |  |  |  |  |  |  |  |  |  |  |  |  |  |  |  |  |  | 133411905 | 1783813322
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
