Shafayat-Alam/Flapping-Foil-Propulsors-Control/for_drive/recent_generated_plots/PID_TUNING.png

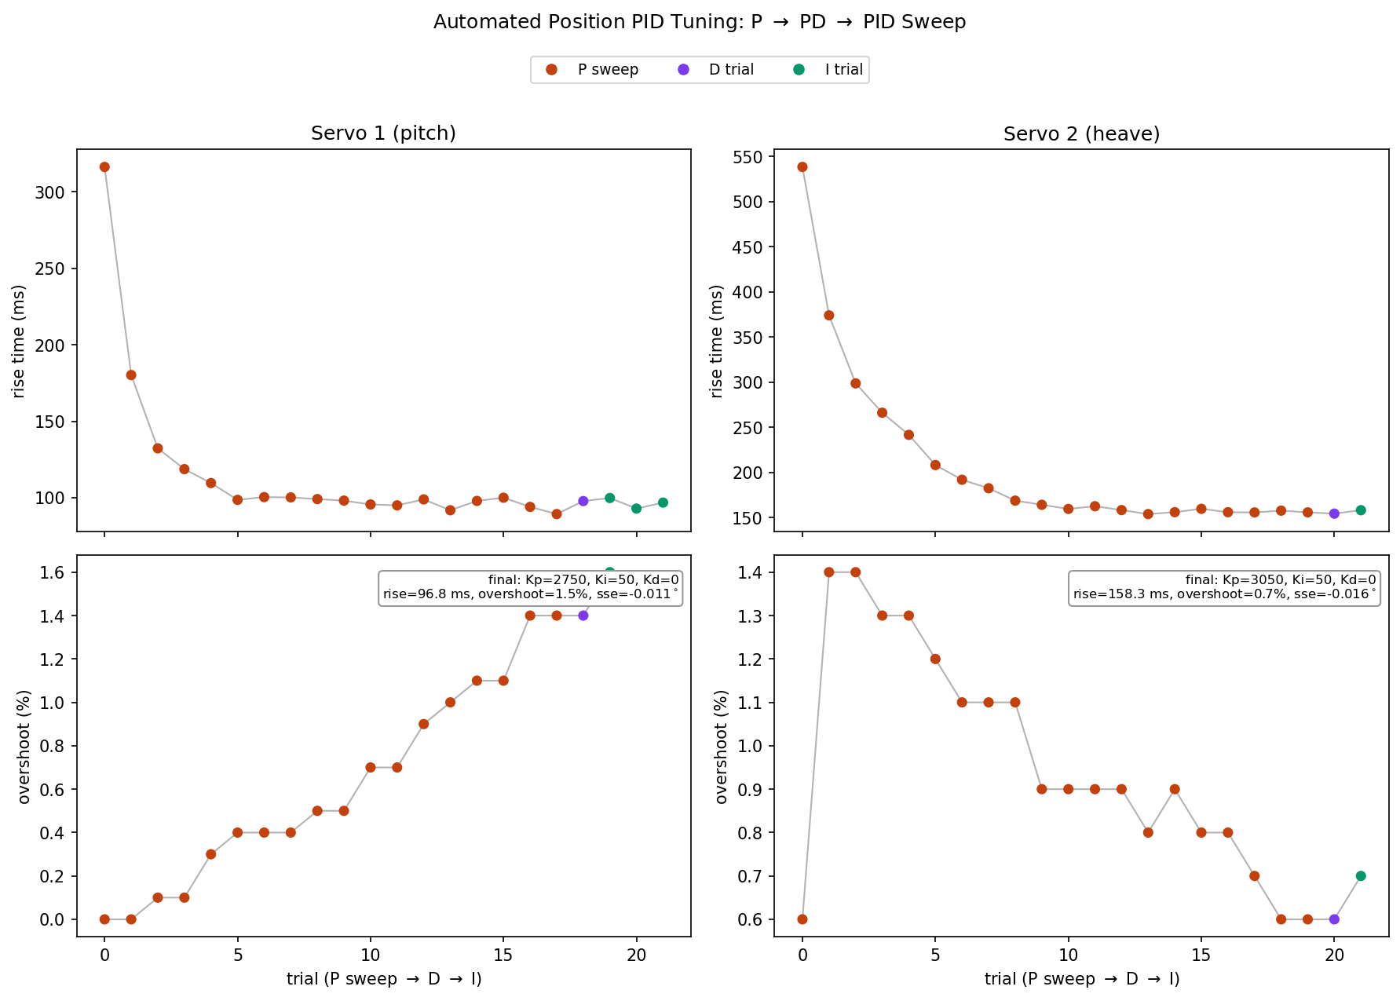
for_drive/recent_generated_plots/PID_TUNING.png
