Shafayat-Alam/Flapping-Foil-Propulsors-Control/for_drive/recent_generated_plots/PID_TUNING_OVERLAY.png

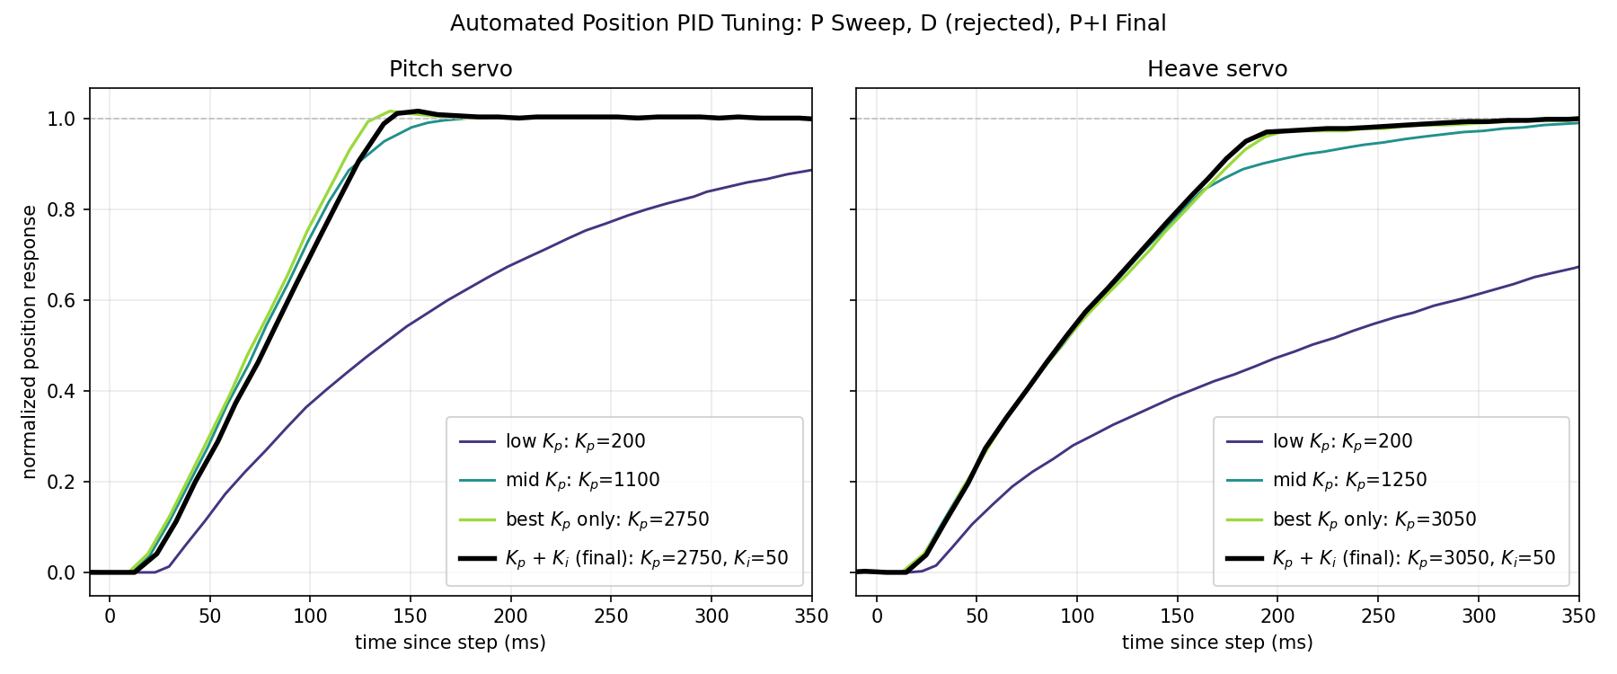
for_drive/recent_generated_plots/PID_TUNING_OVERLAY.png
