Shafayat-Alam/Flapping-Foil-Propulsors-Control/src/prototype_description/urdf/prototype.xacro

<?xml version="1.0" ?>
<robot name="prototype" xmlns:xacro="http://www.ros.org/wiki/xacro">

<xacro:include filename="$(find prototype_description)/urdf/materials.xacro" />
<xacro:include filename="$(find prototype_description)/urdf/prototype.ros2control" />
<xacro:include filename="$(find prototype_description)/urdf/prototype.gazebo" />
<link name="base_link">
  <inertial>
    <origin xyz="-0.30899099029165195 0.0012108888668969147 0.0015750000000000009" rpy="0 0 0"/>
    <mass value="1.2850313556237054"/>
    <inertia ixx="0.009139" iyy="0.030103" izz="0.03924" ixy="-0.0" iyz="0.0" ixz="0.0"/>
  </inertial>
  <visual>
    <origin xyz="0 0 0" rpy="0 0 0"/>
    <geometry>
      <mesh filename="file://$(find prototype_description)/meshes/base_link.stl" scale="0.001 0.001 0.001"/>
    </geometry>
    <material name="silver"/>
  </visual>
  <collision>
    <origin xyz="0 0 0" rpy="0 0 0"/>
    <geometry>
      <mesh filename="file://$(find prototype_description)/meshes/base_link.stl" scale="0.001 0.001 0.001"/>
    </geometry>
  </collision>
</link>

<link name="stellarhd-wetlink_1">
  <inertial>
    <origin xyz="-0.021000020936753683 0.0023021334072860222 2.2846147291338825e-07" rpy="0 0 0"/>
    <mass value="0.37191904393122094"/>
    <inertia ixx="8.4e-05" iyy="7.6e-05" izz="8.4e-05" ixy="-0.0" iyz="0.0" ixz="0.0"/>
  </inertial>
  <visual>
    <origin xyz="0.287891 -0.110458 -0.0294" rpy="0 0 0"/>
    <geometry>
      <mesh filename="file://$(find prototype_description)/meshes/stellarhd-wetlink.stl" scale="0.001 0.001 0.001"/>
    </geometry>
    <material name="silver"/>
  </visual>
  <collision>
    <origin xyz="0.287891 -0.110458 -0.0294" rpy="0 0 0"/>
    <geometry>
      <mesh filename="file://$(find prototype_description)/meshes/stellarhd-wetlink.stl" scale="0.001 0.001 0.001"/>
    </geometry>
  </collision>
</link>

<link name="stellarhd-bracket_1">
  <inertial>
    <origin xyz="-0.014949832549455366 2.837484025519643e-07 0.007794889986392118" rpy="0 0 0"/>
    <mass value="0.028628064173343685"/>
    <inertia ixx="3e-06" iyy="1.2e-05" izz="1.1e-05" ixy="0.0" iyz="0.0" ixz="0.0"/>
  </inertial>
  <visual>
    <origin xyz="0.294041 -0.110458 -0.00315" rpy="0 0 0"/>
    <geometry>
      <mesh filename="file://$(find prototype_description)/meshes/stellarhd-bracket.stl" scale="0.001 0.001 0.001"/>
    </geometry>
    <material name="silver"/>
  </visual>
  <collision>
    <origin xyz="0.294041 -0.110458 -0.00315" rpy="0 0 0"/>
    <geometry>
      <mesh filename="file://$(find prototype_description)/meshes/stellarhd-bracket.stl" scale="0.001 0.001 0.001"/>
    </geometry>
  </collision>
</link>

<link name="left_Aerial_Truss_Structure3_1">
  <inertial>
    <origin xyz="-0.12411757462955986 -0.5809102001753234 0.001575000000006679" rpy="0 0 0"/>
    <mass value="0.08754866154833155"/>
    <inertia ixx="0.000159" iyy="0.00045" izz="0.000609" ixy="0.0" iyz="0.0" ixz="-0.0"/>
  </inertial>
  <visual>
    <origin xyz="0.579463 -0.579463 -0.0" rpy="0 0 0"/>
    <geometry>
      <mesh filename="file://$(find prototype_description)/meshes/left_Aerial_Truss_Structure3.stl" scale="0.001 0.001 0.001"/>
    </geometry>
    <material name="silver"/>
  </visual>
  <collision>
    <origin xyz="0.579463 -0.579463 -0.0" rpy="0 0 0"/>
    <geometry>
      <mesh filename="file://$(find prototype_description)/meshes/left_Aerial_Truss_Structure3.stl" scale="0.001 0.001 0.001"/>
    </geometry>
  </collision>
</link>

<link name="right_Aerial_Truss_Structure3_1">
  <inertial>
    <origin xyz="0.12411757462956012 -0.04039120017532343 -0.0015750000000065818" rpy="0 0 0"/>
    <mass value="0.08754866154833155"/>
    <inertia ixx="0.000159" iyy="0.00045" izz="0.000609" ixy="-0.0" iyz="-0.0" ixz="-0.0"/>
  </inertial>
  <visual>
    <origin xyz="0.039519 -0.038944 -0.00315" rpy="0 0 0"/>
    <geometry>
      <mesh filename="file://$(find prototype_description)/meshes/right_Aerial_Truss_Structure3.stl" scale="0.001 0.001 0.001"/>
    </geometry>
    <material name="silver"/>
  </visual>
  <collision>
    <origin xyz="0.039519 -0.038944 -0.00315" rpy="0 0 0"/>
    <geometry>
      <mesh filename="file://$(find prototype_description)/meshes/right_Aerial_Truss_Structure3.stl" scale="0.001 0.001 0.001"/>
    </geometry>
  </collision>
</link>

<link name="electronics_box_1">
  <inertial>
    <origin xyz="0.13250000000000006 0.00033149078128963275 0.0028288877602833428" rpy="0 0 0"/>
    <mass value="8.109333145299782"/>
    <inertia ixx="0.045437" iyy="0.077245" izz="0.101726" ixy="0.0" iyz="-6.4e-05" ixz="0.0"/>
  </inertial>
  <visual>
    <origin xyz="0.442491 -0.0 -0.001575" rpy="0 0 0"/>
    <geometry>
      <mesh filename="file://$(find prototype_description)/meshes/electronics_box.stl" scale="0.001 0.001 0.001"/>
    </geometry>
    <material name="silver"/>
  </visual>
  <collision>
    <origin xyz="0.442491 -0.0 -0.001575" rpy="0 0 0"/>
    <geometry>
      <mesh filename="file://$(find prototype_description)/meshes/electronics_box.stl" scale="0.001 0.001 0.001"/>
    </geometry>
  </collision>
</link>

<link name="right_roll_servo_1">
  <inertial>
    <origin xyz="0.0004910091311879361 -0.022971963132577967 2.190088388420719e-17" rpy="0 0 0"/>
    <mass value="0.3630867612612132"/>
    <inertia ixx="8.9e-05" iyy="6.2e-05" izz="0.000102" ixy="-2e-06" iyz="-0.0" ixz="-0.0"/>
  </inertial>
  <visual>
    <origin xyz="0.123682 -0.011712 -0.001575" rpy="0 0 0"/>
    <geometry>
      <mesh filename="file://$(find prototype_description)/meshes/right_roll_servo.stl" scale="0.001 0.001 0.001"/>
    </geometry>
    <material name="silver"/>
  </visual>
  <collision>
    <origin xyz="0.123682 -0.011712 -0.001575" rpy="0 0 0"/>
    <geometry>
      <mesh filename="file://$(find prototype_description)/meshes/right_roll_servo.stl" scale="0.001 0.001 0.001"/>
    </geometry>
  </collision>
</link>

<link name="right_pitch_servo_1">
  <inertial>
    <origin xyz="0.023527934247580137 0.0004911122576693884 2.6454533008646308e-17" rpy="0 0 0"/>
    <mass value="0.3630867612612132"/>
    <inertia ixx="6.2e-05" iyy="8.9e-05" izz="0.000102" ixy="-2e-06" iyz="0.0" ixz="0.0"/>
  </inertial>
  <visual>
    <origin xyz="0.101182 0.000788 -0.001575" rpy="0 0 0"/>
    <geometry>
      <mesh filename="file://$(find prototype_description)/meshes/right_pitch_servo.stl" scale="0.001 0.001 0.001"/>
    </geometry>
    <material name="silver"/>
  </visual>
  <collision>
    <origin xyz="0.101182 0.000788 -0.001575" rpy="0 0 0"/>
    <geometry>
      <mesh filename="file://$(find prototype_description)/meshes/right_pitch_servo.stl" scale="0.001 0.001 0.001"/>
    </geometry>
  </collision>
</link>

<link name="right_pitch_FRX430-H105K_1">
  <inertial>
    <origin xyz="0.12251391006422618 0.01573365916397316 0.0059619999999900065" rpy="0 0 0"/>
    <mass value="0.02592343937573193"/>
    <inertia ixx="9e-06" iyy="4e-06" izz="9e-06" ixy="0.0" iyz="-0.0" ixz="0.0"/>
  </inertial>
  <visual>
    <origin xyz="0.168363 0.016213 0.004387" rpy="0 0 0"/>
    <geometry>
      <mesh filename="file://$(find prototype_description)/meshes/right_pitch_FRX430-H105K.stl" scale="0.001 0.001 0.001"/>
    </geometry>
    <material name="silver"/>
  </visual>
  <collision>
    <origin xyz="0.168363 0.016213 0.004387" rpy="0 0 0"/>
    <geometry>
      <mesh filename="file://$(find prototype_description)/meshes/right_pitch_FRX430-H105K.stl" scale="0.001 0.001 0.001"/>
    </geometry>
  </collision>
</link>

<link name="left_pitch_servo_1">
  <inertial>
    <origin xyz="-0.0004910091311878806 -0.02297196313257798 1.7564075194265172e-17" rpy="0 0 0"/>
    <mass value="0.3630867612612132"/>
    <inertia ixx="8.9e-05" iyy="6.2e-05" izz="0.000102" ixy="2e-06" iyz="0.0" ixz="0.0"/>
  </inertial>
  <visual>
    <origin xyz="0.4943 -0.011712 -0.001575" rpy="0 0 0"/>
    <geometry>
      <mesh filename="file://$(find prototype_description)/meshes/left_pitch_servo.stl" scale="0.001 0.001 0.001"/>
    </geometry>
    <material name="silver"/>
  </visual>
  <collision>
    <origin xyz="0.4943 -0.011712 -0.001575" rpy="0 0 0"/>
    <geometry>
      <mesh filename="file://$(find prototype_description)/meshes/left_pitch_servo.stl" scale="0.001 0.001 0.001"/>
    </geometry>
  </collision>
</link>

<link name="left_FRX430-S105K_1">
  <inertial>
    <origin xyz="-0.004369488895370366 3.9431371385309586e-07 1.2841117058570717e-13" rpy="0 0 0"/>
    <mass value="0.01834155822688401"/>
    <inertia ixx="4e-06" iyy="3e-06" izz="2e-06" ixy="0.0" iyz="0.0" ixz="0.0"/>
  </inertial>
  <visual>
    <origin xyz="0.5153 0.000788 -0.001575" rpy="0 0 0"/>
    <geometry>
      <mesh filename="file://$(find prototype_description)/meshes/left_FRX430-S105K.stl" scale="0.001 0.001 0.001"/>
    </geometry>
    <material name="silver"/>
  </visual>
  <collision>
    <origin xyz="0.5153 0.000788 -0.001575" rpy="0 0 0"/>
    <geometry>
      <mesh filename="file://$(find prototype_description)/meshes/left_FRX430-S105K.stl" scale="0.001 0.001 0.001"/>
    </geometry>
  </collision>
</link>

<link name="left_roll_servo_1">
  <inertial>
    <origin xyz="-0.02352793424757993 0.0004911122576693729 1.7564075194265172e-17" rpy="0 0 0"/>
    <mass value="0.3630867612612132"/>
    <inertia ixx="6.2e-05" iyy="8.9e-05" izz="0.000102" ixy="2e-06" iyz="-0.0" ixz="-0.0"/>
  </inertial>
  <visual>
    <origin xyz="0.5168 0.000788 -0.001575" rpy="0 0 0"/>
    <geometry>
      <mesh filename="file://$(find prototype_description)/meshes/left_roll_servo.stl" scale="0.001 0.001 0.001"/>
    </geometry>
    <material name="silver"/>
  </visual>
  <collision>
    <origin xyz="0.5168 0.000788 -0.001575" rpy="0 0 0"/>
    <geometry>
      <mesh filename="file://$(find prototype_description)/meshes/left_roll_servo.stl" scale="0.001 0.001 0.001"/>
    </geometry>
  </collision>
</link>

<link name="left_FRX430-H105K_1">
  <inertial>
    <origin xyz="-0.607132910064226 0.015733659163973172 -0.005961999999989951" rpy="0 0 0"/>
    <mass value="0.02592343937573193"/>
    <inertia ixx="9e-06" iyy="4e-06" izz="9e-06" ixy="-0.0" iyz="0.0" ixz="0.0"/>
  </inertial>
  <visual>
    <origin xyz="-0.034 0.016213 -0.007537" rpy="0 0 0"/>
    <geometry>
      <mesh filename="file://$(find prototype_description)/meshes/left_FRX430-H105K.stl" scale="0.001 0.001 0.001"/>
    </geometry>
    <material name="silver"/>
  </visual>
  <collision>
    <origin xyz="-0.034 0.016213 -0.007537" rpy="0 0 0"/>
    <geometry>
      <mesh filename="file://$(find prototype_description)/meshes/left_FRX430-H105K.stl" scale="0.001 0.001 0.001"/>
    </geometry>
  </collision>
</link>

<link name="right_FRX430-S105K_1">
  <inertial>
    <origin xyz="0.004369488895370449 3.94313713829135e-07 1.2842613257568747e-13" rpy="0 0 0"/>
    <mass value="0.01834155822688401"/>
    <inertia ixx="4e-06" iyy="3e-06" izz="2e-06" ixy="0.0" iyz="-0.0" ixz="-0.0"/>
  </inertial>
  <visual>
    <origin xyz="0.102682 0.000788 -0.001575" rpy="0 0 0"/>
    <geometry>
      <mesh filename="file://$(find prototype_description)/meshes/right_FRX430-S105K.stl" scale="0.001 0.001 0.001"/>
    </geometry>
    <material name="silver"/>
  </visual>
  <collision>
    <origin xyz="0.102682 0.000788 -0.001575" rpy="0 0 0"/>
    <geometry>
      <mesh filename="file://$(find prototype_description)/meshes/right_FRX430-S105K.stl" scale="0.001 0.001 0.001"/>
    </geometry>
  </collision>
</link>

<joint name="Rigid 9" type="fixed">
  <origin xyz="0.00615 0.0 0.02625" rpy="0 0 0"/>
  <parent link="stellarhd-bracket_1"/>
  <child link="stellarhd-wetlink_1"/>
</joint>

<joint name="Rigid 10" type="fixed">
  <origin xyz="-0.294041 0.110458 0.00315" rpy="0 0 0"/>
  <parent link="base_link"/>
  <child link="stellarhd-bracket_1"/>
</joint>

<joint name="Rigid 17" type="fixed">
  <origin xyz="-0.613463 0.595676 -0.007537" rpy="0 0 0"/>
  <parent link="left_FRX430-H105K_1"/>
  <child link="left_Aerial_Truss_Structure3_1"/>
</joint>

<joint name="Rigid 22" type="fixed">
  <origin xyz="0.128844 0.055157 0.007537" rpy="0 0 0"/>
  <parent link="right_pitch_FRX430-H105K_1"/>
  <child link="right_Aerial_Truss_Structure3_1"/>
</joint>

<joint name="Rigid 23" type="fixed">
  <origin xyz="-0.442491 0.0 0.001575" rpy="0 0 0"/>
  <parent link="base_link"/>
  <child link="electronics_box_1"/>
</joint>

<joint name="Rigid 26" type="fixed">
  <origin xyz="-0.123682 0.011712 0.001575" rpy="0 0 0"/>
  <parent link="base_link"/>
  <child link="right_roll_servo_1"/>
</joint>

<joint name="Rigid 28" type="fixed">
  <origin xyz="0.0015 0.0 0.0" rpy="0 0 0"/>
  <parent link="right_FRX430-S105K_1"/>
  <child link="right_pitch_servo_1"/>
</joint>

<joint name="Revolute 29" type="continuous">
  <origin xyz="-0.067181 -0.015425 -0.005962" rpy="0 0 0"/>
  <parent link="right_pitch_servo_1"/>
  <child link="right_pitch_FRX430-H105K_1"/>
  <axis xyz="0.0 1.0 0.0"/>
</joint>

<joint name="Rigid 30" type="fixed">
  <origin xyz="-0.4943 0.011712 0.001575" rpy="0 0 0"/>
  <parent link="base_link"/>
  <child link="left_pitch_servo_1"/>
</joint>

<joint name="Revolute 31" type="continuous">
  <origin xyz="-0.021 -0.0125 0.0" rpy="0 0 0"/>
  <parent link="left_pitch_servo_1"/>
  <child link="left_FRX430-S105K_1"/>
  <axis xyz="-1.0 0.0 0.0"/>
</joint>

<joint name="Rigid 32" type="fixed">
  <origin xyz="-0.0015 0.0 0.0" rpy="0 0 0"/>
  <parent link="left_FRX430-S105K_1"/>
  <child link="left_roll_servo_1"/>
</joint>

<joint name="Revolute 33" type="continuous">
  <origin xyz="0.5508 -0.015425 0.005962" rpy="0 0 0"/>
  <parent link="left_roll_servo_1"/>
  <child link="left_FRX430-H105K_1"/>
  <axis xyz="0.0 1.0 -0.0"/>
</joint>

<joint name="Revolute 34" type="continuous">
  <origin xyz="0.021 -0.0125 0.0" rpy="0 0 0"/>
  <parent link="right_roll_servo_1"/>
  <child link="right_FRX430-S105K_1"/>
  <axis xyz="1.0 0.0 -0.0"/>
</joint>

</robot>
