Shafayat-Alam/Flapping-Foil-Propulsors-Control/src/soft_propulsors_control/launch/crab_launch.py

"""
crab_launch.py — Hardware System Launch File
============================================
Brings up the full autonomous stack on real hardware:

  crab        (mission dispatcher + config master)
      │  robot_config (latched)  →  controller
      │  mission_cmd             →  controller
      ▲  mission_status          ←  controller
  controller  (autonomous execution engine)
      │  joint_cmd               →  servo_actuator
      ▲  joint_feedback          ←  servo_actuator
      ▲  imu_data                ←  icm20948_imu
      ▲  apriltag_detections     ←  apriltag_interface (camera)

crab is the single source of truth for robot structure: the actuator map,
operating mode, rates, and nominal gait all live on the crab node here and are
broadcast once at startup.  Per-DOF servo settings unique to the hardware
(port, baudrate, servo PID gains) stay on the servo_actuator node.

Actuator map entry: [id, set_id, custom?]
  id                      — Dynamixel servo id
  set_id                  — servos sharing a set form one fin; within a set the
                            FIRST entry is roll, the SECOND is pitch
  custom (optional)       — spare per-servo value passed through for a
                            motion_command function (unused for now)

Position limits are fixed by role in the controller (roll 0..2π, pitch 0..π),
not carried in the actuator map.

Homing is calibrated once on the servo itself (e.g. via Dynamixel Wizard) and
NEVER touched by this stack — no node here reads or writes the Homing Offset
register; Present Position 0 is always trusted as home.

Init sequence: crab drives home_state (all servos → 0), waits
operational_readiness seconds, then standby (mid-range rest pose), before any
mission_input is processed.

Missions are fed at runtime on the /mission_input topic — see
scripts/feed_missions.sh.
"""

import os
from datetime import datetime

from launch import LaunchDescription
from launch.actions import DeclareLaunchArgument, ExecuteProcess
from launch.conditions import IfCondition
from launch.substitutions import LaunchConfiguration, PythonExpression
from launch_ros.actions import Node
from launch_ros.parameter_descriptions import ParameterValue

PACKAGE = 'soft_propulsors_control'

# record_session.py lives in scripts/, in the workspace root. Relative-path
# derivation from __file__ doesn't work here: `ros2 launch` always loads the
# INSTALLED copy of this file (install/soft_propulsors_control/share/
# soft_propulsors_control/launch/crab_launch.py, a plain copy, not a
# --symlink-install symlink back to src/), which sits at a different depth
# relative to the workspace root than the source copy does — walking a fixed
# number of '..' up from __file__ lands inside install/, not the workspace
# root, however many levels you pick, since running from source vs. running
# from the installed copy need different counts. Hardcoded absolute path
# instead (this repo isn't relocated/isn't meant to be — see the similarly
# hardcoded FTDI serial-by-id path a few lines below).
WORKSPACE_ROOT = '/home/shafa/soft-propulsors-control'
RECORDER = os.path.join(WORKSPACE_ROOT, 'scripts', 'record_session.py')


def generate_launch_description():
    # Session recorder args: where to dump the run, and whether to record at all.
    session_arg = DeclareLaunchArgument(
        'session',
        default_value='session_' + datetime.now().strftime('%Y%m%d_%H%M%S'),
        description='Output folder for the recorded session (relative to cwd).')
    record_arg = DeclareLaunchArgument(
        'record', default_value='false',
        description='Record all topics and export per-mission CSVs on shutdown. '
                    'OFF by default: the bag captures the 10 kHz load cell for '
                    'the whole session, so every launch left a multi-GB '
                    'session_* folder behind whether or not anything was run. '
                    'The experiment scripts write their own per-mission CSVs, '
                    'so this is only needed for ad-hoc missions driven through '
                    'the dispatcher. Turn it back on with record:=true.')
    # Loop rates, overridable from the command line so you can sweep them, e.g.
    #   ros2 launch ... crab_launch.py control_rate:=200 hardware_rate:=200
    # to find the highest rate the serial loop can actually sustain.
    control_rate_arg = DeclareLaunchArgument(
        'control_rate', default_value='200.0',
        description='Controller + crab loop rate (Hz).')
    hardware_rate_arg = DeclareLaunchArgument(
        'hardware_rate', default_value='100.0',
        description='Servo write/read loop rate (Hz).')
    control_rate = ParameterValue(LaunchConfiguration('control_rate'), value_type=float)
    hardware_rate = ParameterValue(LaunchConfiguration('hardware_rate'), value_type=float)

    # Started with the stack; on Ctrl+C of the launch it gets SIGINT too, stops
    # the bag, and writes the CSVs.  sigterm/sigkill timeouts are stretched so a
    # large bag has time to finish exporting before launch force-kills it.
    recorder = ExecuteProcess(
        cmd=['python3', RECORDER, LaunchConfiguration('session')],
        output='screen',
        sigterm_timeout='60',
        sigkill_timeout='90',
        condition=IfCondition(
            PythonExpression(["'", LaunchConfiguration('record'), "' == 'true'"])),
    )

    return LaunchDescription([
        session_arg,
        record_arg,
        control_rate_arg,
        hardware_rate_arg,
        recorder,

        # ------------------------------------------------------------------
        # Mission Dispatcher + Configuration Master
        # ------------------------------------------------------------------
        Node(
            package=PACKAGE,
            executable='crab',
            name='crab_mission_dispatcher',
            output='screen',
            parameters=[{
                # Single-fin experiment rig: only servos 1 (pitch) & 2 (heave)
                # are connected. Add '[3, 2], [4, 2]' back for the two-fin robot.
                'actuator_map': '[[1, 1], '
                                '[2, 1]]',
                'operating_mode': 'extended_position',   # 'extended_position' | 'position' | 'velocity'
                'control_rate': control_rate,  # Hz — from launch arg (default 100).
                                               # Verified smooth at 100 Hz end-to-end once
                                               # the FTDI latency_timer is 1 ms; 16 ms
                                               # default caps feedback near 66 Hz. Override:
                                               # control_rate:=<Hz> hardware_rate:=<Hz>
                'operational_readiness': 2.0,  # s — wait after home_state before standby
                'mission_readiness': 2.0,       # s — wait after standby before missions run
                'gait_velocity': 3.77,          # rad/s — nominal peak stroke rate (2π·f·A)
                'gait_effort': 0.6,             # rad — nominal stroke amplitude
                'default_retries': 2,           # auto-retries before asking a human
                # AprilTag id marking each compass heading (set to your printed tags)
                'cardinal_map': '{"N": 0, "E": 1, "S": 2, "W": 3}',
            }],
        ),

        # ------------------------------------------------------------------
        # Autonomous Execution Engine (state machine + outer-loop PID)
        # ------------------------------------------------------------------
        Node(
            package=PACKAGE,
            executable='controller',
            name='controller',
            output='screen',
            parameters=[{
                'kp': 0.0,
                'ki': 0.0,
                'kd': 0.0,
                'control_rate': control_rate,  # Hz — from launch arg (match crab & hardware)
                'telemetry_decimation': 1,      # publish every sample
                'paddle_cycles': 1,            # default gait cycles per command (0 = forever)
                'paddle_velocity': 5.0,        # default paddle velocity (peak stroke rate)
                'paddle_pitch_phase': 1.5707963267948966,  # π/2 — pitch sine phase lead vs roll
                # Output low-pass on every position command to kill setpoint
                # jitter (0 = off; →1 = smoother but more lag).  Weight kept on
                # the previous command each control cycle.
                'command_smoothing': 0.5,
                # Calibration zero pose (rad) that 'calibration' drives every
                # servo to, and that everything (IMU-follow, gaits) references.
                # Both 0 → calibration sets all servos to 0.
                'pitch_zero': 0.0,                  # roll rest position
                'heave_zero': 0.0,                 # pitch rest position
                # Position limits: each servo clamped to its zero ± this (rad).
                # Sole clamp in Extended Position Mode; change freely here.
                'pitch_limit': 3.141592653589793,   # roll:  0 ± π   → [-π, π]
                'heave_limit': 1.5707963267948966, # pitch: 0 ± π/2 → [-π/2, π/2]
            }],
        ),

        # ------------------------------------------------------------------
        # AprilTag Perception (heading cues)
        # Consumes frames republished by stellarhd_camera — it does NOT open the
        # camera itself.  stellarhd_interface is the sole owner of camera hardware.
        # ------------------------------------------------------------------
        Node(
            package=PACKAGE,
            executable='apriltag_interface',
            name='apriltag_interface',
            output='screen',
            parameters=[{
                'source': 'topic',              # frames come from stellarhd
                'image_topic': 'camera/image_raw',
                'tag_family': 'tag36h11',
                'tag_size': 0.10,               # m — physical tag edge length
                # Intrinsics must match the published frame resolution.
                # Replace with your camera calibration.
                'fx': 1000.0, 'fy': 1000.0, 'cx': 960.0, 'cy': 540.0,
            }],
        ),

        # ------------------------------------------------------------------
        # Dynamixel XW430-T200 Hardware Interface with Inner-Loop PID
        # ------------------------------------------------------------------
        Node(
            package=PACKAGE,
            executable='Dynamixel_XW430_T200_interface',
            name='servo_actuator',
            output='screen',
            parameters=[{
                # Stable by-id path for the FTDI adapter — survives replugs and
                # ttyUSB enumeration order (ttyUSB0 vs ttyUSB1) changing.
                'port':       '/dev/serial/by-id/usb-FTDI_USB__-__Serial_Converter_FT9MIR5U-if00-port0',
                'baudrate':   1000000,
                # Per-servo rotation-direction inversion (JSON list of ids).
                # Servo 2 (set 1 heave) rotates the wrong way — reverse it.
                # Servo 1 (set 1 pitch) was also reversed, but pitch up/down
                # came out backwards, so servo 1 is deliberately left OUT of
                # this list (un-reversed) to flip its commanded direction.
                # Servos 3 (set 2 roll) and 4 (set 2 pitch) are correct as-is.
                'reverse_servos': '[2]',
                'hardware_rate': hardware_rate,  # Hz - from launch arg (match control_rate).
                                         # Requires FTDI latency_timer=1 to sustain 100 Hz;
                                         # 16 ms default caps ~66 Hz. This is the loop whose
                                         # serial round-trip sets the real rate ceiling.
                'current_limit': 648,  # XW430-T200 max valid value (1.743 A)

                'servo_position_p_gain': 900,
                'servo_position_i_gain': 0,
                'servo_position_d_gain': 0,
                # Per-servo Position PID override (JSON keyed by servo id),
                # written live when changed at runtime — this is what
                # scripts/pid_tuner.py sets. '' = all servos use the scalars.
                # After tuning, paste the tuner's result here to make it the
                # boot default, e.g. '{"1": {"p": 950, "d": 400}, "2": {...}}'.
                # Identified on the rig IN WATER by scripts/pid_tuner.py
                # (position_pid_tune_full/RESULT.txt), sweeping all three
                # gains rather than pinning Ki. The two servos want very
                # different values -- pitch 2750 vs heave 3050 -- and both
                # are far above the old shared default of 900, which had
                # never been identified from data. Kd converged to 0 on
                # both: overshoot stayed under 1.5% even near Kp 3000, so
                # there was nothing for a derivative term to damp.
                'position_gain_overrides': '{"1": {"p": 2750, "i": 50, "d": 0}, "2": {"p": 3050, "i": 50, "d": 0}}',
                'servo_velocity_p_gain': 100,
                'servo_velocity_i_gain': 1920,
                # Velocity Limit (reg 44) is set on the servo via Wizard, not here.
                # 0 = unlimited (no onboard trapezoidal profile).  The controller
                # STREAMS the gait trajectory at its control rate, so the servo
                # must track each setpoint at full speed — a nonzero profile caps
                # the speed and makes fast phases (e.g. the paddle pitch sweep)
                # lag and never reach their target.  Raise only if you want
                # deliberately slow, capped point-to-point moves.
                'profile_velocity': 0,
                'profile_acceleration': 0,
            }],
        ),

        # ------------------------------------------------------------------
        # ICM20948 9-DOF IMU (Accelerometer + Gyroscope + Magnetometer)
        # ------------------------------------------------------------------
        Node(
            package=PACKAGE,
            executable='icm20948_interface',
            name='icm20948_imu',
            output='screen',
            parameters=[{
                'i2c_bus': 7,             # I2C bus number (/dev/i2c-7)
                'i2c_address': 0x69,      # Default I2C address
                'sample_rate': 100.0,     # Hz - IMU sampling rate
                'frame_id': 'imu_link',   # TF frame name
            }],
        ),

        # ------------------------------------------------------------------
        # StellarHD Camera — sole camera owner: records per-mission video AND
        # republishes frames on camera/image_raw for apriltag_interface.
        # ------------------------------------------------------------------
        Node(
            package=PACKAGE,
            executable='stellarhd_interface',
            name='stellarhd_camera',
            output='screen',
            parameters=[{
                'camera_index': 0,                           # /dev/video0
                'video_width': 1920,                         # Resolution
                'video_height': 1080,
                'fps': 30.0,                                 # Frames per second
                'output_directory': '/home/gingerstep/videos',    # Video save location
                'fourcc': 'mp4v',                            # Codec: 'mp4v', 'XVID', 'H264'
                'publish_images': True,                      # feed perception
                'image_topic': 'camera/image_raw',
                'publish_rate': 15.0,                        # Hz cap for republished frames
            }],
        ),

        # ------------------------------------------------------------------
        # Load-Cell Array — receives a force grid over UDP and republishes it
        # on load_cell_data (also captured by the session recorder).
        # ------------------------------------------------------------------
        Node(
            package=PACKAGE,
            executable='load_cell_interface',
            name='load_cell_interface',
            output='screen',
            parameters=[{
                'udp_port': 5005,             # UDP port the sensor streams to
                'bind_address': '0.0.0.0',    # listen on all interfaces
                'rows': 6,                    # F/T axes per sample [Fx,Fy,Fz,Tx,Ty,Tz]
                'cols': 1000,                 # samples batched per UDP packet (must match LabVIEW)
                'sample_rate': 10000.0,       # Hz — 1000 samples = 100 ms/packet (100 µs apart)
                'topic': 'load_cell_data',
            }],
        ),

    ])
