Shafayat-Alam/Flapping-Foil-Propulsors-Control/scripts/amfm_experiment.py

#!/usr/bin/env python3
"""AM/FM shaping experiment: design + run.

GOAL
----
Measure, for each kinematic knob, (a) how much it moves each force-waveform
metric on Fx and Fy, and (b) how much it disturbs everything else -- so the
answer is a JACOBIAN and a coupling map, not a claim that all twenty metrics
are independently controllable.

STAGES
------
  J  JACOBIAN.   Every knob perturbed +/- around a nominal, one at a time,
                 on each servo. Gives d(metric)/d(knob) by central difference
                 and, from the rank of that matrix, how many metrics are
                 ACTUALLY independent. Central differences rather than
                 one-sided so a nonlinear-but-symmetric response is not
                 mistaken for zero sensitivity.

  S  SWEEP.      The knobs that survive stage J get 5 levels each, so the
                 response curve is characterised rather than assumed linear.
                 A knob whose effect reverses (as a2 did in the harmonic
                 campaign, peaking near 0.3 then falling back) cannot be used
                 by a controller unless that turning point is known.

  R  REPLICATES. The nominal, repeated throughout the run in randomised
                 order. Every claim of "knob X moved metric Y" is judged
                 against this spread, and drift over the session shows up as
                 a trend in it.

EXECUTION MODEL
---------------
One gait cycle is PRECOMPUTED into a position array and replayed at the
hardware rate. The gait is static within a run, so nothing needs to be
recalculated per tick, the cycle repeats exactly (no phase drift), and every
position and velocity in the commanded array is checked against the limits
BEFORE anything moves. Extended-position mode: the commanded angle is its
own bound, unlike velocity mode where an unbounded integration is possible.

usage:
  amfm_experiment.py <folder> --design            # build + verify the plan
  amfm_experiment.py <folder> --run [--stage J]   # execute on the rig
"""
from __future__ import annotations

import argparse
import csv
import json
import math
import os
import sys
import time
from dataclasses import replace

import numpy as np

WORKSPACE_ROOT = "/home/shafa/soft-propulsors-control"
sys.path.insert(0, os.path.join(WORKSPACE_ROOT, "scripts"))
sys.path.insert(0, os.path.join(WORKSPACE_ROOT, "src", "soft_propulsors_control"))

from amfm_waveform import (   # noqa: E402
    Knobs, KNOB_NAMES, cycle, check, max_feasible_period)

# ---- limits, mirroring crab_launch.py -----------------------------------
PITCH_LIMIT = math.pi          # servo 1, +/-180 deg
HEAVE_LIMIT = math.pi / 2      # servo 2, +/-90 deg
SLEW_LIMIT = 5.5               # rad/s
SERVO_LIMITS = {1: PITCH_LIMIT, 2: HEAVE_LIMIT}
# joint_cmd's per-servo "mode" field is a COMMAND TYPE, not the Dynamixel
# operating mode: 3 = position write, 1 = velocity write (see controller.py's
# topic contract). The interface's write phase handles only those two values
# and silently queues NOTHING for anything else -- a 4 here was accepted with
# no error and no write, so the servos held still while the script published
# happily at 100 Hz. Extended-position is selected at the register level by
# operating_mode in crab_launch.py; the goal-position write is identical.
MODE_POSITION = 3

# ---- nominal operating point -------------------------------------------
# Modest amplitudes and a slow period so that every perturbation stays
# feasible; the point of stage J is sensitivity, not maximum force.
PERIOD_S = 2.0
NOMINAL = {
    1: Knobs(A0=0.45, C=0.0, n=1),      # pitch
    2: Knobs(A0=0.35, C=0.0, n=1),      # heave
}
# Perturbation sizes, chosen large enough to clear measurement noise and
# small enough to stay in the locally-linear region.
DELTA = {"A0": 0.10, "C": 0.12, "h_diff": 0.30, "h_com": 0.30,
         "s_diff": 0.45, "s_com": 0.45, "w_diff": 0.45, "w_com": 0.45}
SWEEP_LEVELS = 5

N_CYCLES = 3          # commanded per mission; only cycle 2 is analysed
SETTLE_S = 4.0        # quiet delay between missions
PRE_QUIET_S = 1.5     # recorded BEFORE motion: the force tare baseline
IDLE_TAIL_S = 2.0
HW_RATE = 100.0       # servo write / feedback rate


def knobs_with(base: Knobs, name, value) -> Knobs:
    return replace(base, **{name: value})


def build_plan():
    """Every mission in the campaign, before randomisation."""
    pts = []

    def add(stage, servo, knob, value, rep=0):
        k = dict(NOMINAL)
        k[servo] = (knobs_with(NOMINAL[servo], knob, value)
                    if knob else NOMINAL[servo])
        label = (f"{stage}_s{servo}_{knob}_{value:+.3f}".replace("+", "p").replace("-", "m")
                 if knob else f"{stage}_nominal_{rep}")
        pts.append({"stage": stage, "servo": servo, "knob": knob or "",
                    "value": value if knob else 0.0, "label": label,
                    "k1": k[1], "k2": k[2]})

    # --- J: central differences on every knob, each servo
    for servo in (1, 2):
        for knob in KNOB_NAMES:
            if knob == "n":
                add("J", servo, "n", 2)          # integer: 1 -> 2
                continue
            d = DELTA[knob]
            base = getattr(NOMINAL[servo], knob)
            add("J", servo, knob, base + d)
            add("J", servo, knob, base - d)

    # --- S: response curves for the continuous knobs
    for servo in (1, 2):
        for knob in ("h_diff", "h_com", "s_diff", "s_com", "w_diff", "w_com"):
            d = DELTA[knob]
            base = getattr(NOMINAL[servo], knob)
            for lv in np.linspace(base - d, base + d, SWEEP_LEVELS):
                if abs(lv - base) < 1e-9:
                    continue                      # nominal covered by R
                add("S", servo, knob, float(lv))

    # --- P: GAIT C, the prediction test set.
    # Deliberately NOT +/- perturbations of the nominal and NOT points on the
    # stage-S sweeps: several knobs move together, and the period and crest
    # count differ. A model fitted on A (stage J) and selected on B (stage S)
    # has therefore never seen anything like these, so predicting them is a
    # real test rather than interpolation inside the training region.
    # Predictions are written down BEFORE these run -- see greybox_report.py.
    rng = np.random.default_rng(17)
    for i in range(12):
        k1 = Knobs(A0=float(rng.uniform(0.25, 0.60)),
                   C=float(rng.uniform(-0.15, 0.15)),
                   n=int(rng.choice([1, 1, 2])),
                   h_diff=float(rng.uniform(-0.35, 0.35)),
                   h_com=float(rng.uniform(-0.30, 0.30)),
                   s_diff=float(rng.uniform(-0.50, 0.50)),
                   s_com=float(rng.uniform(-0.50, 0.50)),
                   w_diff=float(rng.uniform(-0.50, 0.50)),
                   w_com=float(rng.uniform(-0.50, 0.50)))
        k2 = Knobs(A0=float(rng.uniform(0.20, 0.45)),
                   C=float(rng.uniform(-0.12, 0.12)),
                   n=int(rng.choice([1, 1, 2])),
                   h_diff=float(rng.uniform(-0.30, 0.30)),
                   s_diff=float(rng.uniform(-0.40, 0.40)),
                   w_diff=float(rng.uniform(-0.40, 0.40)))
        pts.append({"stage": "P", "servo": 0, "knob": "gaitC",
                    "value": float(i), "label": f"P_gaitC_{i:02d}",
                    "k1": k1, "k2": k2})

    # --- R: replicates
    for r in range(6):
        add("R", 1, None, 0.0, rep=r)
    return pts


def verify(pt):
    """Feasibility of one mission against position and slew limits."""
    problems = []
    for servo, key in ((1, "k1"), (2, "k2")):
        p = pt[key].to_params()
        ok, info = check(p, PERIOD_S, SERVO_LIMITS[servo], SLEW_LIMIT)
        if not ok:
            problems += [f"servo{servo}: {x}" for x in info["problems"]]
        pt[f"s{servo}_pos_min"] = round(info["pos_min"], 4)
        pt[f"s{servo}_pos_max"] = round(info["pos_max"], 4)
        pt[f"s{servo}_vel_peak"] = round(info["vel_peak"], 3)
        pt[f"s{servo}_Tmin"] = round(max_feasible_period(
            p, SERVO_LIMITS[servo], SLEW_LIMIT), 3)
    pt["feasible"] = (len(problems) == 0)
    pt["problems"] = "; ".join(problems)
    return pt


def design(folder, seed=5):
    pts = [verify(p) for p in build_plan()]
    rng = np.random.default_rng(seed)
    for rank, i in enumerate(rng.permutation(len(pts)), 1):
        pts[i]["run_order"] = rank
    pts.sort(key=lambda p: p["run_order"])

    os.makedirs(folder, exist_ok=True)
    rows = []
    for p in pts:
        row = {kk: p[kk] for kk in
               ("run_order", "stage", "servo", "knob", "value", "label",
                "feasible", "problems", "s1_pos_min", "s1_pos_max",
                "s1_vel_peak", "s2_pos_min", "s2_pos_max", "s2_vel_peak")}
        for sv, key in ((1, "k1"), (2, "k2")):
            for kn, vv in p[key].as_dict().items():
                row[f"s{sv}_{kn}"] = vv
        rows.append(row)
    out = os.path.join(folder, "plan.csv")
    with open(out, "w", newline="") as fh:
        w = csv.DictWriter(fh, fieldnames=list(rows[0]))
        w.writeheader()
        w.writerows(rows)

    n_bad = sum(1 for r in rows if not r["feasible"])
    per = N_CYCLES * PERIOD_S + SETTLE_S + PRE_QUIET_S + IDLE_TAIL_S
    print(f"{len(rows)} missions -> {out}")
    for st in ("J", "S", "P", "R"):
        print(f"   stage {st}: {sum(1 for r in rows if r['stage']==st)}")
    print(f"   infeasible: {n_bad}")
    if n_bad:
        for r in rows:
            if not r["feasible"]:
                print(f"     {r['label']}: {r['problems']}")
    print(f"   period {PERIOD_S}s x {N_CYCLES} cycles (cycle 2 analysed) "
          f"+ {SETTLE_S}s delay + {PRE_QUIET_S}s pre-quiet "
          f"+ {IDLE_TAIL_S}s tail = {per:.0f}s/mission")
    print(f"   estimated {len(rows)*per/60:.0f} min")
    return rows
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
