Shafayat-Alam/Flapping-Foil-Propulsors-Control/scripts/run_harmonic_sweep.py

#!/usr/bin/env python3
"""Execute the harmonic control-authority sweep on the rig.

Reads the plan CSV produced by design_harmonic_sweep.py, runs each mission
in the plan's randomised order, and writes one load-cell CSV per mission
plus a manifest. Analysis is a separate step (analyse_harmonic_sweep.py) so
a bad analysis choice never costs rig time twice.

Per mission: 3 cycles commanded, a 4 s quiet delay before each set, and a
2 s idle tail recorded after motion stops. The idle tail is what allows a
per-mission tare -- the previous campaign saved a calibration block for
only 1 of its 35 cells, which forced the whole analysis to be rewritten
around inferring the baseline. Two seconds of quiet per mission is cheap
insurance against repeating that.

Safety: every point is re-checked against the slew and amplitude limits
immediately before it is commanded, even though the plan was generated
inside them -- a hand-edited plan should not be able to drive the servos
past their limits.

usage: run_harmonic_sweep.py <folder> [--blocks A,B,C] [--dry-run]
"""
import argparse
import csv
import math
import os
import sys
import time

import numpy as np

WORKSPACE_ROOT = "/home/shafa/soft-propulsors-control"
sys.path.insert(0, os.path.join(WORKSPACE_ROOT, "scripts"))
sys.path.insert(0, os.path.join(WORKSPACE_ROOT, "src", "soft_propulsors_control"))

import design_harmonic_sweep as dhs   # noqa: E402  (limits + kinematics live here)

SETTLE_S = 4.0
IDLE_TAIL_S = 2.0
N_CYCLES = 3


def mission_line(row, label):
    """Build the forward_paddle mission line for one plan row.

    freq_ratio is INVERTED relative to the plan's column: the plan follows
    the 3D campaign's convention (heave/pitch), while the mission line's
    freq_ratio multiplies the pitch frequency to get heave. Getting this
    backwards silently runs the mirror-image gait, so it is done in one
    place and asserted against the plan's own heave_freq_hz below.
    """
    fr_plan = float(row["freq_ratio"])
    mission_fr = fr_plan          # heave_freq = pitch_freq * mission_fr
    pitch_f = float(row["pitch_freq_hz"])
    expect_heave = pitch_f * mission_fr
    assert abs(expect_heave - float(row["heave_freq_hz"])) < 1e-3, (
        f"freq_ratio convention mismatch on {label}: "
        f"{expect_heave:.4f} vs {row['heave_freq_hz']}")

    parts = [
        "forward_paddle",
        f"frequency:{pitch_f:.6f}",
        f"pitch_amp:{float(row['pitch_amp_rad']):.6f}",
        f"heave_amp:{float(row['heave_amp_rad']):.6f}",
        # Heave phase offset. At a rational freq_ratio the two servos lock
        # into a fixed relative pattern, so peak count is set by the lock's
        # denominator and CANNOT be changed by phase -- which makes phase a
        # free parameter for reshaping the waveform at constant peak count.
        # It was pinned at 0 for every mission of the first three campaigns.
        f"phase:{math.radians(float(row.get('phase_deg', 0.0) or 0.0)):.6f}",
        f"freq_ratio:{mission_fr:.6f}",
        "pitch_k:0.000000",     # 0 = plain sine; a3 carries width instead
    ]
    for key, col in (("p_a2", "p_a2"), ("p_phi2", "p_phi2"), ("p_a3", "p_a3"),
                     ("h_a2", "h_a2"), ("h_phi2", "h_phi2"), ("h_a3", "h_a3")):
        v = float(row.get(col, 0.0) or 0.0)
        if key.endswith("phi2"):
            v = math.radians(v)     # plan stores degrees, mission wants radians
        parts.append(f"{key}:{v:.6f}")
    parts.append(f"pitch_bias:{float(row.get('pitch_bias_rad', 0.0) or 0.0):.6f}")
    parts.append(f"cycles:{N_CYCLES}")
    parts.append(f"label:{label}")
    return " ".join(parts)
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
