Shafayat-Alam/Flapping-Foil-Propulsors-Control/(commit log)

2026-05-07 Refactor ROS2 control architecture: telemetry-driven execution, motion library extensibility, and per-servo data organization
    Major architectural changes:
    - Motion library: gaits.py → motion_library.py with kwargs-based extensibility
    - Telemetry-driven control: 400 Hz feedback loop replacing timer-based execution
    - Position limits: Moved to motion_cmd wire format (single source of truth)
    - Servo-level gait control: Functions can command individual servos or synchronized groups
    - Emergency safety: SIGINT handler for instant torque disable on Ctrl+C
    Motion library enhancements:
    - Flexible kwargs support (freq_ratio, amp_ratio, phase_offset, custom params)
    - drive_multi() for simultaneous mu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
    [joint_cmd.csv, joint_feedback.csv, motion_cmd.csv, robot_cmd.csv, telemetry.csv, telemetry_snippet.csv]
2026-05-20 Name change
    [Component87.stl, base_link.stl, controller.yaml, electronics box.stl, left_Aerial_Truss_Structure3.stl, left_FRX430-H105K.stl, left_FRX430-S105K.stl, left_pitch_servo.stl]
2026-07-05 Add interactive per-servo boot sequence with operational-readiness gating
    Boot now walks home_state, then standby, one servo at a time, waiting on
    real encoder feedback (not a timer) to confirm each has settled, with a
    y/n operator check after each before advancing. Operational-readiness
    and mission-readiness waits bracket the sequence so the robot only
    starts accepting missions once the operator has confirmed every servo.
    Also:
    - Stop touching Homing Offset entirely; trust Wizard-calibrated zero
    - Enforce hard position clamps (Min/Max Position Limit) per servo role
    instead of a shared full-circle range
    - Fix mission_cmd/mission_status QoS (now TRANSIENT_LOCAL) so a message
    published be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
    [Dynamixel_XW430_T200_interface.py, controller.py, crab.py, crab_launch.py, gazebo_launch.py]
2026-07-09 added flapping gait and sweep + loadcell function to find optimal sine function.
    [CALIBRATION.csv, FORWARD_PADDLE.csv]
2026-09-07 Add parametric study analysis, grey-box model fitting, and hardware interface docs
    - New scripts/ tooling for AMFM waveform shaping, grey-box blade-element
    model fitting, 3D parametric sweep analysis, and combined-claim plotting
    - New for_drive/ figures for the amplitude/frequency/phase parametric study
    and the Fz out-of-plane coupling finding
    - Rewrite README.md to document actual node architecture, state machine,
    mission dispatch logic, and hardware register map, verified against source
    - Update subsea_mission_assurance model/docs and add the V-Model rung
    - Remove stale calibration/forward-paddle CSVs superseded by split_data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
    [CALIBRATION.csv, FORWARD_PADDLE.csv, ICD.csv, Interface_Requirements.csv, pid_tune.json, session.csv]
2026-09-07 Document Gazebo SIL and HIL architecture, rebrand as Flex Fin
    - Add Simulation section: hybrid real/sim servo detection and per-ID
    feedback merge, IMU/camera fallback behavior, and the kinematic-only
    (zero-gravity, no buoyancy/drag model) scope of the Gazebo world
    - Add Hardware-in-the-Loop section: how an external script joins the live
    ROS graph through the existing mission_input/mission_status path instead
    of a separate control channel, and the load_cell_interface UDP bridge
    - Rename project title to Flex Fin in README, ROS 2 package name unchanged
